sigmanssery/INAUSIS/DATA/RAWCHANNEL_2026-08-28.md

# 原始通道 + 單通道轉換(2026-08-28 夜)

## 為什麼

2026-08-28 語料庫顯示 C/D/F/G 在力道配平後分不開(見
`FINDINGS_2026-08-28_force-confound.md`)。封包只載三路 DoG 輸出,最快的
DoG_fast 到 150 Hz 已衰減 −32 dB,所以按壓之間若真有高頻差異,根本傳不出來。

## 兩個改動

**1. `dsp_chain.v`:dim 12 改載 CH0 原始值。**
只覆寫 `dog_flat`,旗標引擎仍由 feeder FSM 的 `lat_*` 餵,行為與 dead map 不變
(dim 12 仍報 dead=1 卻帶著活資料)。

**2. `ttcgs_board.v`:ADS 改成 `SINGLE_CH=1, SINGLE_IDX=0`。**

這一條才是關鍵。**改 dim 12 之後才發現原始值每 4~5 幀才變一次 —— 有效更新率
只有 159 Hz**,因為 ADS 仍在四通道輪詢,`CH0_ONLY` 只改了封包排程沒改轉換排程。
資訊 Nyquist 只有 79.5 Hz,跟 DoG_fast 的 70 Hz 截止幾乎一樣,**加原始通道等於白加**。

`SINGLE_CH=1` 只轉 AIN5(就是現用的 ch0),159 → 584 SPS,Nyquist 292 Hz。

    改前 dim12  run 4.34 幀  ->  159 Hz
    改後 dim12  run 1.09 幀  ->  631 Hz

> 2026-08-28 更正:本節下方曾記「市電佔靜止雜訊功率 61%」。那是拿一段手在附近的
> 錄音算的。手確實離開 30 cm 時只有 **3.5%**;手指輕放才是 85.8%。
> **市電是接觸傳導進來的**,見 `SLIDE_DETECT_2026-08-28.md`。

靜止雜訊頻譜實測(10~70 Hz 相對 100~300 Hz 的落差):

    159 SPS   −11.8 dB   (階梯保持造成的滾降)
    584 SPS   − 1.2 dB   (平坦到 345 Hz)
    d2 = G(s3) 參考:30 Hz 以上掉到止帶,平坦約 20 dB

**代價**:ch1~ch3 不再轉換,dims 3~11 凍結,dead map 由 `0x3F000` 變 `0x3FFF8`。
那三個通道沒接感測器。

## bitstream

    board_raw12.fs    只加 dim12,仍四通道輪詢(159 SPS)—— 無用,別拿來錄
    board_raw584.fs   dim12 + SINGLE_CH=1(584 SPS)—— 用這顆

資源 Logic 3820/8640、Fmax 37.763 MHz、Setup 違例 0。歸檔
`impl_archive/2026-08-28_board_raw12/`(前者)。

## 重要:不與 2026-08-28 語料庫相容

那 30 筆的有效取樣率是 159 SPS,這顆是 584 SPS。**DoG 的頻帶在兩者之下不同**
(舊資料的資訊上限 79.5 Hz),不可混在一起比。這顆錄的是獨立的高頻探測實驗。

還有:目前只燒在 SRAM,拔電就沒了。確定要用再 `-Flash`。

## 待答的問題

按壓類之間(C/D/F/G)在 79.5~292 Hz 有沒有可分的內容?
有 → 力道混淆有解;沒有 → 主張收窄成「滑動 vs 按壓」。

---

# 結果(8 筆,`2026-08-28_hf_mod*`,n=2/類)

## 高頻確實存在,而且以前完全看不到

接觸期間相對靜止的頻帶能量:

    類      0-20Hz   20-80Hz  80-150Hz  150-292Hz
    C/G/F   +52~58   +23~33   +17~20    +22~25
    E       +50~53   +22~27   +22~28    +26~32

80 Hz 以上有 +17~32 dB 的真實訊號。舊組態的資訊上限是 79.5 Hz,**這些內容從來
沒有離開過 FPGA**。

## 但高頻救不了 C vs G

    C1 vs G1   80-150Hz +0.7 dB   150-292Hz +0.1 dB
    C1 vs G2            +1.0                 +0.1
    C2 vs G1            +3.0                 +2.9
    C2 vs G2            +3.2                 +2.8

而 **C1 與 C2 之間就差 2.1~2.8 dB** —— 類內差異與類間差異同量級。
把頻寬拉大 4 倍之後,按壓類之間依然分不開,與白天力道配平的結論一致。

## 但滑動 vs 按壓拿到了力道穩健的特徵

**頻譜傾斜 = (150–292 Hz) − (0–20 Hz)**,這個量本身即對整體振幅正規化:

    按壓 (C/G/F)  -33.9 ~ -31.2 dB    |g3| 14300~18897
    滑動 (E)      -25.9 ~ -22.4 dB    |g3| 13514~17557
    間隙 5.4 dB

**兩者的 |g3| 範圍互相重疊**(E 落在按壓類之內),所以這是天然力道配平的比較。

    傾斜 vs 力道   r = -0.26
    fast/g3 vs 力道 r = -0.91   (白天那 30 筆)

力道依賴性從 r=−0.91 降到 −0.26。**這是目前唯一一個力道穩健、且需要原始通道
才算得出來的特徵。**

## 注意

n=2/類,r=−0.26 是 8 個點算的,不確定性大。這 8 筆與白天 30 筆取樣率不同,
不可合併。下一步應加錄重複數,並在**每一類之內刻意變化力道**,才能真正檢定
傾斜的力道穩健性 —— 白天的教訓就是類內力道太一致會製造假象。

---

# 刻意變力道的驗證(9 筆,`_f1/_f2/_f3`,合計 n=17)

每一類之內把力道拉開 1.9 倍(峰值目標 13000 / 22000 / 30000)。

    按壓 (C/G/F)  n=12   傾斜 -32.44 +- 1.05 dB   |g3| 11417~22028
    滑動 (E)      n= 5   傾斜 -24.80 +- 2.30 dB   |g3| 10797~20205

    均值差 7.65 dB   合併 sd 1.49   Cohen d = 5.15
    最小間隙 +3.3 dB(按壓最高 -30.7 對滑動最低 -27.4),不重疊

**力道依賴性消失:**

    傾斜 vs 力道   全體    r = -0.10 (n=17)
                   按壓類內 r = +0.04 (n=12)
                   滑動類內 r = +0.06 (n= 5)
    對照 fast/g3            r = -0.91 (n=30,白天)

兩類的 |g3| 範圍幾乎完全重疊,而傾斜在類內對力道毫無反應 —— 這不是碰巧配平,
是這個量本身就與力道無關。

**C vs G 依然重疊**(C −33.7~−30.7,G −33.9~−32.0),與力道配平、高頻探測
兩條證據一致:按壓類之間沒有可分的內容。

## 這批的效力邊界

* 單一受試者、單一場、單一感測器
* 滑動只有 n=5,且其 sd(2.30)大於最小間隙(3.3 dB)—— 多錄幾筆有機會吃掉間隙
* 力道範圍 1.9 倍,不是更大
* 兩個區塊(17:29~17:36 順序 C,G,F,E 與 17:47~17:54 順序 C,G,E)落點一致,
  但都在同一個 25 分鐘視窗內 —— **仍需斷電換序的第二場才算複現**,
  這正是白天那個教訓
