sigmanssery/INAUSIS/DATA/SOAK_2026-08-29_10h.md

# 10 小時靜置 soak(2026-08-29)

`2026-08-29_quiet_real10h.csv`,1.84 GB。組態:`board_final.fs`
(真實感測器、`SINGLE_CH=1`、`N_SQ=25`(5σ)、校正自癒、冷開機修正)。
感測器上方為 **MRE**(先前的 soak 用海綿,會乾掉;這次不會)。

## 主機端(`log_frames.py` 收工摘要)

    frames 24804408 in 36000.1s (689/s) | badCRC 0 | resync 0 | dropped 0 stale

## 檔案端(獨立重算,逐幀掃描)

    幀數        24,804,408      時長 10.00 小時      689.0 fps
    時戳跳號    0 次            遺失 0 幀 = 0.000000%
    dead map    0x3FFF8         24,804,408 幀全部相同
    status      1               全部相同
    mask 觸發   0 幀 = 0.000000%
    接觸旗標    0 幀            uncal 0 幀

兩邊獨立算出一致。**2480 萬幀零 CRC 錯誤、零丟幀、零狀態變化、零誤觸發。**

## 基線穩定度

    d2  逐小時均值 1781.19 -> 1780.62   = −0.57 counts / 10 小時
    d12 逐小時均值 1781.69 -> 1781.12   = −0.57 counts / 10 小時
    d2  的 sd 全程 2.15 ~ 2.20(十小時內幾乎不動)

## 第 8 小時的雜訊上升:是市電,不是感測器

    時   d0 sd    d12 sd
    0-7  7.40->7.64  31.7->36.4    緩慢爬升
    8    11.13       40.15         <- d0 跳 46%
    9    10.61       36.72

頻譜分解(60 秒窗):

    時段     寬頻(20-300Hz,扣掉市電線)   60Hz 線     120Hz 線
    第 2 h            63.4 dB              +14.5 dB    +30.1 dB
    第 8 h            63.7 dB              +24.6 dB    +34.3 dB
    第 9 h            63.3 dB              +29.1 dB    +31.4 dB

**寬頻底噪三段完全相同,漲的只有市電線(60 Hz +10~15 dB)。**
市電佔總功率:d12 由 37.1% 升到 53.6%,**d0 由 7.1% 升到 39.1%**。

d2 的 sd 不受影響,因為它濾到 1.8 Hz,60 Hz 進不去;d0 的通帶是 14~70 Hz,正中。
時間上對應早晨家電陸續開機。

## 最重要的結論

**即使 d0 的雜訊漲了 46%、市電佔到它功率的 39%,整整 2480 萬幀仍然零誤觸發。**

這比 2026-08-28 的「五次開機皆 0.00%」強:那是在安靜條件下量的,
這是在雜訊實際劣化的條件下撐住的。**3σ→5σ(`N_SQ` 9→25)的改動由此得到驗證** ——
3σ 時同一塊板的靜止誤觸發會在 0~16.94% 之間跳。

## 未解:市電是昨晚基準的十倍

    2026-08-28 夜、60 秒、手離開 30cm   d12 sd 25.94   市電佔 3.5%
    本次 soak 第 2 小時                 d12 sd 32.93   市電佔 37.1%

差十倍。**leading hypothesis 是 MRE**(順應層可能提供耦合路徑),
但**未經測試**,也可能只是時段/家電差異。

分辨方法:同一天、手完全離開、各錄 60 秒完整穩態,有 MRE / 無 MRE 各一次,
比 d12 sd 與市電佔比。若 MRE 是主因,那是**順應層的代價**,要寫進論文;
若不是,那是環境,不是設計屬性。

## 與先前鏈路數字的關係

2026-08-28 記的「186 萬幀、遺失 0.0106%」仍然成立,那批的遺失全部集中在單一檔案的
一次 0.29 秒中斷(`H_slide2`)。本次 10 小時連續錄製**零遺失**,樣本數大 13 倍。
兩者不衝突:前者含一次主機端中斷,後者沒有。
