sigmanssery/INAUSIS/DATA/DETECTION_SPEC_2026-08-28.md

# 偵測規格(2026-08-28 / 29)

真值來源分兩種:**合成刺激**(時序解析度,由建構決定)與
**真實接觸配上原始通道 dim12 當刺激真值**(偵測延遲)。兩者都不依賴操作者的一致性。

主張從「分辨手勢」收窄成「**告訴下游有沒有接觸、在哪一維**」之後量的規格。
這正是 TTCGS 本來的輸出:給下游 SoC 的注意力遮罩(`mask` / `mask_failsafe` /
`dead`),分類是後來才加上去、而且兩次複現都失敗的東西。

真值由 `synth_press` 建構決定,**不依賴任何人的手**。

## 靜止誤判率

**只用確定沒接觸的錄音**(手離開 30 cm / 懸空 2 cm / 手指靜放不施力 /
冷開機檢查),合計 **80,424 幀 = 116.7 秒**:

    接觸旗標 (status bit2)   0 幀
    mask dim0 (DoG_fast)     0 幀
    mask dim1 (DoG_slow)     0 幀
    mask dim2 (G_s3)         0 幀

**三個活維度全部零誤觸發**,包括手指靜放在感測器上的 30 秒。

> **更正**:本節原記 dim0 誤觸發 0.606%。那個數字是拿語料庫檔案的「前 3 秒」
> 當靜止算的,而那些窗並非靜止(`H3_slide2` 一開始就在滑,d0 變異 423,240)。
> **同一個錯誤犯了兩次**(另一次是挑 `VAR_CEIL` 的基準值)——
> **靜止基準只能用確定沒碰過的錄音。**

對照:真實按壓時 dim0 的觸發持續中位 28 幀 = 40 ms(n=26,全距 1~59)。

## 偵測延遲:用真實接觸重測(2026-08-29)

合成刺激那條路被白雜訊擋住(見下),但**原始通道 dim12 本身就是精確的刺激真值** ——
它是未濾波的轉換器輸出。以「raw 跨過自身峰值 10%」為起點、
「mask 任一活維度拉起」為終點,量既有的真實按壓/滑動錄音:

    115 個事件(`2026-08-28_H2_*` 與 `H3_*`)
    延遲中位 **2 個樣本 = 2.90 ms**,全距 0~6 樣本
    與事件峰值無關(22000~30000 與 30000+ 兩箱皆為 2 樣本)

### 5σ 重測:延遲不變(2026-08-29 定案)

以現行 5σ 組態重錄:

    firm 按壓 8 次   延遲 **全部 2 樣本**,零離散
    分級按壓 16 次   中位 2 樣本,16 個裡 14 個落在 2~3 樣本
    合計 24 個事件於 5σ;對照 3σ 的 115 個事件,中位同為 2 樣本 = 2.90 ms

**門檻提高 2.78 倍完全沒有增加延遲。** 按壓的上升緣夠陡,DoG_fast 在同一個
樣本內衝過兩個門檻,所以延遲由**核的前載形狀**決定而非由門檻決定。

### 為什麼偵測下限用手指探不到

要求操作者做「由弱到強」的階梯後發現:

    raw(未濾波瞬時值) 峰值 24857 ~ 30986   <- 幾乎不隨力道變化
    d2(低通後持續載荷)峰值  4828 ~ 19929   <- 六倍跨度

**手指再輕,接觸的上升緣仍然很陡**,raw 照樣接近滿刻度;變輕的是持續載荷。
而偵測由快頻帶觸發,所以每一次都輕鬆越過門檻 —— 16 次全部偵測到,零漏。

**要接近偵測下限,需要「振幅小 *且* 上升緩慢」的刺激,那是手做不出來的。**
這正是合成產生器的用途,而那條路目前卡在白雜訊(見下)。
**下限因此仍然未知,原因是刺激源而不是設備。**

### 為什麼 2.90 ms 在機制上說得通

濾波器核是**因果且前載**的,不是置中的對稱高斯:

    G_s1      能量重心 tap  5.3 =  7.7 ms   峰值在 tap 5
    G_s2      能量重心 tap  9.1 = 13.1 ms
    DoG_fast  能量重心 tap  9.2 = 13.4 ms   50% 能量在 tap 7 = 10.2 ms
    G_s3      能量重心 tap 67.0 = 97.2 ms   <- 只有它是長的

tap 0 就有權重,所以陡峭上升緣一進來輸出立刻開始動。
若核是置中對稱的,群延遲會是 128 樣本 = 186 ms,那與觀測不符。

## 偵測下限:沒有硬下限,是一條延遲—振幅曲線(2026-08-29 定案)

合成產生器的白雜訊問題**已修**(見文末的 LFSR 根因),校正因此得到合理的門檻,
`dim2` 不再 free-run。以精確真值(產生器的週期起點)為基準重測:

| 設定峰值 | 延遲(樣本) | 延遲(ms) | n | 偵測率 | 逐次 |
|---|---|---|---|---|---|
| 14025 | 6 | 9.4 | 2 | 100% | 7 6 |
| 6985 | 8 | 11.6 | 2 | 100% | 8 8 |
| 3520 | 10 | 13.8 | 2 | 100% | 10 9 |
| 1760 | 10 | 15.2 | 2 | 100% | 10 11 |
| 880 | 14 | 21.0 | 2 | 100% | 14 15 |
| 440 | 19 | 27.6 | 2 | 100% | 20 18 |
| 385 | 21 | 29.8 | 4 | 100% | 18 22 19 22 |
| 330 | 21 | 30.5 | 4 | 100% | 21 21 16 21 |
| 275 | 24 | 34.1 | 4 | 100% | 26 26 21 20 |
| 220 | 29 | 41.4 | 4 | 100% | 31 26 23 37 |
| 165 | 28 | 39.9 | 4 | 100% | 40 26 29 24 |
| 110 | 44 | 63.9 | 4 | 100% | 48 44 39 44 |
| **55** | **70** | **100.9** | 4 | **100%** | 69 70 68 70 |

**兩段掃描(28000~219 粗掃、440~55 細掃)都是 100% 偵測,探不到底。**
55 counts 對靜止 raw 的 sd 37 只有 **1.5σ**,仍然偵測得到 ——
DoG 在通帶內平均了約十個樣本,濾波後的信噪比遠優於逐樣本。

**這不是誤觸發**:55 counts 那四次的延遲是 69/70/68/70,緊到不可能是雜訊;
且同組態靜止十小時、2480 萬幀零誤觸發(`SOAK_2026-08-29_10h`)。

**因此正確的規格陳述是「延遲隨振幅上升」,不是「下限是某個值」。**
上升時間固定 55 樣本(80 ms),所以 55 樣本以下的延遲代表在爬升途中就報了;
55 counts 那一列的 70 樣本已進入持平段。

> 量到的峰值一律比設定高約 99 counts,那是用 `max()` 取峰值被雜訊尖峰墊高的
> (sd 37 之下,約 1000 個樣本的最大值約在 +3σ),不是刺激本身。

## ⚠ 舊的合成刺激版(白雜訊污染,不可用)

**這一節的數字被合成刺激的一個限制污染,尚未重測。**

`synth_press` 的雜訊是 LFSR 產生的**白**雜訊。G_s3 只通 0.2~1.8 Hz,白雜訊幾乎被
濾光,所以校正窗量到的 G_s3 變異只有 **0.1**(真實感測器是 4.16,因為真雜訊含
1/f、市電與熱漂移)。門檻因此被設得極低,**dim2 在整段掃描中有 31% 的幀在誤觸發**。

而延遲與下限是用「dims 0/1/2 任一拉起」量的,其中一維在亂跳,結果不可信。

要重測需要二選一:
* 讓 `synth_press` 的雜訊帶低頻成分(對 LFSR 做整形),使 G_s3 被真實地驅動
* 或改用真實接觸量偵測(按壓的偵測不像滑動那樣依賴執行質地,可行)

**不受影響的是靜止誤判率** —— 那是用 `SYNTH=0`、真實感測器量的,見上一節。

## (原始記錄,待重測)

`2026-08-28_detect_sweep2.csv`,160 秒、峰值對數掃描,每級 3 次。
延遲從「刺激跨過自身峰值 10%」起算到 mask 任一活維度拉起。

| 設定峰值 | 量到峰值 | 偵測率 | 延遲(樣本) | 延遲(ms) |
|---|---|---|---|---|
| 28000 | 28042 | 100% | 5 | 7.3 |
| 14025 | 14067 | 100% | 5 | 7.3 |
| 6985 | 7028 | 100% | 8 | 11.6 |
| 3520 | 3562 | 100% | 57 | 82.7 |
| 1760 | 1799 | 100% | 98 | 142.2 |
| 880 | 921 | 100% | 186 | 270.0 |
| 440 | 480 | **0%** | — | — |
| 219 | 257 | **0%** | — | — |

**偵測下限在 440 ~ 880 counts 之間**(靜止 d2 的 sd 為 2.4 counts)。
參考按壓的延遲是 **4 個樣本 = 5.81 ms**,三次重複完全相同。

延遲隨振幅單調上升,是門檻偵測器在斜坡刺激上的必然行為:訊號越小,
越晚跨過門檻。門檻可經現有反向通道(`lut_parser`)重調,
所以這條曲線是**可移動的設計取捨**,不是固定限制。

## 原始通道在正常按壓時削頂(2026-08-29)

    接觸期間 33,409 幀中有 9,370 幀 raw >= 32700 = **28.05%**
    每事件被削的樣本中位 34~89(約 49~129 ms),事件長約 250~350 樣本
    d2(濾波後)幾乎不削 —— 只有 0.79%,且僅見於一筆

**已驗證這不影響 H 的結論**:把削頂樣本整個排除後重算,
兩類中位由 3.08 / 3.84 升到 3.40 / 4.02,但 **Cohen d 1.16 → 1.13、
門檻 3.30 的正確率 64.6% → 63.9%** —— 分離度不變。
(此處 d 較低是因為併了兩場,而第二場的滑動側已知塌掉。)

但它仍是一個真實的動態範圍限制:**分壓比/PGA 增益使得偏重的按壓會撞上 ADC 滿刻度**,
峰值附近的高頻內容因此被削掉。若要保留那段內容,需改 `R_div` 或 PGA ——
但那會改變所有既有的校正與基線,是獨立的決定。

## 一個必須記下的失效模式:校正窗被污染

第一次掃描 **mask 在全部 110,355 幀都是 0**,從未觸發。

原因:`zscore_flag_multi` 只在開機後前 `CAL_N = 512` 個樣本校正一次,而合成刺激
一啟動就按壓,一次按壓 234 個樣本**整個落在校正窗內**。引擎量到滿刻度的變異、
把門檻設到無法到達,之後永久失效。

加上 1400 樣本(約 2 秒)的靜默前導後,mask 觸發 35,515 / 110,354 幀。

**這會發生在真實硬體上:開機後 0.74 秒內若有任何東西碰到感測器,
注意力輸出就永久失效,而且不會自我恢復。**

這是今天第二次遇到「校正一次、且校在髒資料上」——
第一次是冷開機時 ADS 輸出全零,導致 dead map 全死(見 `COLDSTART_2026-08-28.md`)。
**同一個結構性弱點:一次性校正沒有有效性檢查。**
建議(未實作):校正後檢查變異是否落在合理範圍,超出則重做。

---

# 合成雜訊的根因與修法(2026-08-29,已解)

## 症狀

合成刺激下 `G_s3` 的靜止變異只有 **0.1**,真實感測器是 **4.65**。門檻因此低到
`dim2` 幾乎持續觸發,第一次偵測下限掃描整個作廢。

## 走錯的路(丟掉一整晚)

假設真實雜訊是 1/f,想用漏積分器「補低頻」。**假設本身是錯的。**

拿 10 小時 soak 的第 2 小時、5 分鐘窗量真實靜止頻譜:

    0.1~1 Hz  1~5 Hz  5~20 Hz  20~60 Hz   相對 1~5 Hz
     -0.0 dB  +0.0 dB  +0.2 dB   +1.2 dB
    細看 G_s3 通帶內:0.1~0.3 / 0.3~0.6 / 0.6~1.0 / 1.0~1.8 Hz
                      +0.4    +0.1     -0.4     +0.0 dB

**真實雜訊在 0.1~30 Hz 平坦到 ±0.4 dB —— 是白的,沒有 1/f。**
抬高的只有 60~200 Hz 的市電諧波。異常的是合成端,不是真實端。

## 真正的根因:LFSR 每個樣本只移一位

`lfsr[6:0]` 取 7 個位元,而每個樣本只右移一位 ——
**相鄰兩個樣本共用其中 6 個位元**,序列因此強相關,不是白雜訊。

Python 用真實量化係數驗證(每個樣本推進的步數):

    步數/樣本   raw 變異   d2 變異   d2/raw     相鄰自相關
        1        1365.2     0.151   0.00011      -0.247
        2        1370.5     5.960   0.00435      -0.130
        8        1366.1     9.092   0.00666      -0.002
    真實感測器    1085.0     4.650   0.00429

**每樣本推進 8 步**(8 個位元不重疊)就恢復成白雜訊。
八步線性遞迴仍是線性的,所以合成成一個固定 XOR 網路,不佔時脈。

與真實值 0.00429 的殘差**不是缺陷**:真實訊號有 30~40% 的功率在 60 Hz 以上的
市電諧波,那些被 `G_s3` 擋掉,所以真實比值低於純白雜訊。合成端不該複製市電,
**0.0066 就是正確的目標**。

## 硬體驗證

修法後同一顆合成 bitstream:`dim2` 在 12 個零載荷週期**全部 0% 觸發**,
只在產生器刻意施加載荷的 4 個週期觸發 100%,而量到的抬升
(+48 / +90 / +170 / +327)精確追蹤設定值(40 / 80 / 160 / 320)。

> 先前記的「dim2 free-run 31~57%」歸因有誤 ——
> 那批數字混了校正窗污染與這個**合法**的載荷觸發。

## 方法論

昨晚在 RTL 上連續猜錯四次;今天先在 Python 用真實係數把假設驗完才動 RTL,
一次就對。**先量目標(10 小時 soak 給了真實頻譜),再設計。**
