sigmanssery/INAUSIS/DATA/FINDINGS_2026-08-28_force-confound.md

# DoG 頻帶比主要在量力道,不是手勢(2026-08-28)

## 結論

**`fast/g3` 與 `slow/g3` 有 83% 的變異由接觸力道 |g3| 解釋**(30 筆,
r = −0.912,log-log 回歸斜率 −1.63:力道加倍,fast/g3 掉到 0.32 倍)。
類內相關 C −0.90、D −0.89、E −0.98、F −1.00、G −0.98。

力道配平(|g3| 相差 <5%)後兩兩比對:

| 比較 | n | fast/g3 差異中位 | 全距 |
|---|---|---|---|
| 同一類,力道差 >15% | 27 | **39%** | 最大 83% |
| C/D/F/G 彼此,力道配平 | 25 | **8%** | 0~27% |
| E vs 其他,力道配平 | 18 | **38%** | 25~57% |

**改變力道的影響是改變類別的五倍。** 具體的配平對照:

    C5 vs G3   |g3| 15150/15626   fast/g3 0.125 / 0.125   差 0%
    C4 vs D5   |g3| 18321/18118   fast/g3 0.095 / 0.096   差 0%
    F6 vs G1   |g3| 14544/14053   fast/g3 0.151 / 0.151   差 0%
    C6 vs G6   |g3| 18792/18807   fast/g3 0.090 / 0.088   差 3%

**C、D、F、G 在力道配平後分不開。E 分得開。**

## 這是怎麼被發現的

第一場(2026-08-28 12:31~16:28)五類各連續錄一批,十對可分性全部通過,
最弱 3%。**那是假象**:每類各自的力道剛好穩定,而五類本來就落在不同力道水準
(D 最重 17520~21309,F 最輕 8930~14544)。類別與錄製時段完全混淆。

第二場依協定斷電重開、**類別順序倒過來**(G→E→C→F→D)各錄 2 筆之後,
**十對裡有五對變成兩軸都重疊**。第二場執行本身沒問題 —— 事件數、提示標記、
幀率、零貼頂、零時戳跳號全部與第一場吻合,變的只有力道。

協定「分兩場、中間斷電、換順序」這條規則就是為了抓這個,而它抓到了。

## 還剩下什麼

**E(單向拉撫)vs 按壓類**,力道配平後仍差 38%,是乾淨的。與波形圖一致:
E 的 d0 在整個接觸期間是持續振盪,C/D/F/G 都是單一暫態尖峰 —— 滑動與按壓
是兩種物理過程,而「節奏不同的按壓」不是。

C/D/F/G 之間唯一 10/10 可分的特徵是**事件率**(最弱間隙 13%),但事件率是
節拍器規定的,不是量出來的,拿來當分類結果是循環論證。

試過但無效的力道無關特徵(皆 n=6/類,注意多重比較):
力道迴歸殘差 4/10、|d0| 佔空比 3/10、峰值位置佔比 3/10、d0 對 d2 峰值延遲 4/10。

## 與 chirp 結果的關係(不衝突)

先前的 chirp 特性描述(Spearman 1.0000、16 倍振幅範圍內不變 0.2~8.7%)仍然成立,
但那是**固定波形、只縮放振幅**。人手加大力道不是把波形放大 —— 上升較慢、接觸較久,
**形狀就變了**,比值對此並不免疫。

正確的說法是「**對振幅不變**」,不能寫成「對力道不變」。

## 建議

不要再為 C/D/F/G 補資料 —— 力道配平的配對已經在手上,答案是 0~8%,
再錄不會改變。要嘛把主張收窄到「滑動 vs 按壓」,要嘛換一條特徵路線。
