sigmanssery/INAUSIS/DATA/FRONTEND_RESOLUTION_2026-08-28.md

# 前端解析度(合成刺激,真實 RTL)

## 為什麼要做

2026-08-28 的手勢語料庫量到的是**手**,不是前端:同一操作者的上升時間 sd 是
43 ms,而前端的解析度是 1.45 ms —— **差 30 倍**。用手做的手勢無法支撐任何關於
前端解析度的主張,因為執行變異把儀器解析度整個淹掉。

## 做法

`synth_press.v` 在 FPGA 內產生梯形按壓串,經 `SYNTH=1` 取代 ch0 的轉換器樣本。
**下游全部是出貨邏輯** —— 真實的整數 MAC、`>>FRAC`、飽和、旗標引擎、封包器、
鏈路。手和感測器都被移除,剩下的只有前端本身。

32 步程式,四個 8 步階段各掃一個參數,每階段從同一個基準按壓出發,
步進 0/1/2/3/5/9/17/33 單位。step 索引輸出到 dim 13(`AUX_DIM`),
主機直接讀,不必推論順序。噪聲由 LFSR 產生(均勻,sd≈37)。

> **更正(2026-08-29)**:此處原寫「對照實測 raw 的 44.2」。那個 44.2 是傍晚錄的,
> 當時手在附近,市電經接觸傳導把雜訊抬高了近一倍。**手確實離開 30 cm 時是 25.94**
> (60 秒、41,454 幀、整段計算)。所以 LFSR 的 sd≈37 其實比真實感測器**高** 1.4 倍,
> 不是原本以為的略低。這使本文的解析度數字偏保守,結論方向不變。

`2026-08-28_sweep32_long.csv`,160 秒 = 3~4 輪。

## 結果

| 參數 | 設定步進 | 量測步進 | 重複 sd | 解析度 |
|---|---|---|---|---|
| 上升時間 | +1 樣本 | +1.0 樣本 | **0.00** | **1 樣本 = 1.45 ms** |
| 持續時間 | +1 樣本 | +1.0 樣本 | **0.00** | **1 樣本 = 1.45 ms** |
| 按壓間載荷 | +5 counts | +5.5 counts | 1.2~4.6 | **約 5 counts** |
| 峰值 | −140 counts | −148.7 counts | 0.4~7.1 | **約 15 counts = 0.05%** |

上升時間用 10–90% 判準,所以量測斜率是設定的 0.8 倍(0.8×55=44、0.8×88=70.4),
逐步的 +1 對 +1 是在該斜率下的完全追蹤。持續時間是 1:1(+16 設定 → +16 量測)。

## 對照:同一操作者的執行變異

(語料庫 C 類 6 筆、48 次真實按壓)

    上升時間  中位 177 ms   sd 43.4 ms   = 30 樣本    -> 前端好 30 倍
    接觸時長  中位 360 ms   sd 47.7 ms   = 33 樣本    -> 前端好 33 倍
    峰值      中位 26839    sd 3103 counts = 11.9%    -> 前端好 200 倍

## C 與 G 為什麼分不開,精確答案

兩者的定義差異是「按壓之間手指在不在表面上」。操作者實際做出的按壓間載荷是
**0~3 counts**(見 `FINDINGS_2026-08-28_force-confound.md`),而前端要 **5 counts**
才分得出來。**那個差異落在解析度以下** —— 不是特徵不好、不是頻寬不夠,
是該手勢定義所產生的物理量太小。

FSR 轉導的是力。手指放著但不施力,訊號上不存在。

## 效力邊界

* 噪聲是均勻 LFSR 的**白**頻譜,不是實測頻譜。**這對本文的時序解析度無影響**
  (上升/持續/載荷只看波形),但**使同一支產生器無法用來量偵測門檻** ——
  G_s3 只通 0.2~1.8 Hz,白雜訊幾乎被濾光,詳見 `DETECTION_SPEC_2026-08-28.md`
* > **更正**:此處原寫「實測有 61% 功率在市電線上」。那是手在附近時算的;
  > **手確實離開時市電只佔 3.5%**,見 `SLIDE_DETECT_2026-08-28.md` 的市電對照
* 單一組態、單一板子
* 這是**解析度**(能分辨多小的差異),不是**準確度**(絕對值對不對)
* 建置 Logic 4465/8640,只用於特性描述,不是量產組態
