sigmanssery/INAUSIS/DATA/PROTOCOL_MODALITY.md

# 接觸方式協定 (2026-08-27 定案:五類,直接接觸)

> ## ⛔ 這套五類語料庫已不能用於分類主張(2026-08-28 起)
>
> 依此協定錄的 30 筆語料庫**量到的是操作者的手,不是前端**:
> 同一操作者的上升時間 sd 是 **43 ms**,而前端的解析度是 **1.45 ms** —— 差 30 倍。
>
> * **C 對 G 分不開**:兩者的定義差異(按壓之間手指在不在表面)只產生
>   **0~3 counts**,而前端要 **5 counts** 才分得出來 —— 落在解析度以下。
>   FSR 轉導的是力;手指放著不施力,訊號上不存在。
> * 本文下方所有「頻帶比 C 0.24 vs G 0.37」「逐筆完全不重疊」的數字
>   **已被力道混淆推翻**(`fast/g3` 有 83% 變異來自力道,r=−0.912)。
> * 第一場「十對全部分開」是**類別與錄製時段完全混淆**的假象;
>   斷電換序的第二場有五對變成兩軸都重疊。
>
> **協定本身(手勢定義、提示音、峰值目標)仍然有效**,可用於記錄真實接觸;
> 不可用於支撐手勢分類的能力主張。
> 詳見 `FINDINGS_2026-08-28_force-confound.md` 與 `SESSION_2026-08-28_LEDGER.md`。

檔名:`YYYY-MM-DD_FSR402_mod<字母><重複編號>_raw.csv`

## 五類 x 7 次 = 35 筆

| 代號 | 手勢 | 30 秒內目標 | 單次時長 | 峰值 counts |
|---|---|---|---|---|
| **C** | 規律按壓,力道有變化 | 約 8 次 | **0.15~0.6 s** | 27000~30000 |
| **D** | 單次施力—放鬆(彼此分開) | 約 7 次 | 各自分離 | 27000~30000 |
| **E** | **單向拉撫**(只拉不推) | 持續 | — | \|g3\| 15000 上下 |
| **F** | 指甲敲擊 | 約 45 下 | 短促 | 不設目標 |
| **G** | 快速規律按壓,**全程不放開** | 約 20 次 | ~0.35 s | 27000~30000 |

**字母跳過 A 和 B,不重新編號** —— 舊批次的同名檔是別的手勢。

## 用提示音錄製(2026-08-28 起)

`log_frames.py` 內建節拍器,**提示時刻會寫進 CSV 的 `cue` 欄**(3=預備低音 400 Hz,
1=按下音 1000 Hz,2=放開音 500 Hz,0=無)。分析時因此有指示時刻的基準真值,不必再從訊號反推事件。
排程用絕對時間,實測 48 拍累積誤差 7.1 ms。

第一聲是**預備低音**(`--cue-leadin`,預設 1 聲),之後才是按下音;08-28 的 C1~C4 有
三筆漏掉第一拍,加這聲就是為此。預備音之前留一段乾淨靜止窗供 sd 基準用。

標記寫進 CSV 的時刻誤差 **+3~12 ms**(讀取塊 512 B)。曾用 4096 B,誤差是 +70~100 ms
—— 標記只能掛在「主迴圈處理到那一列」時,塊越大偏得越多。**不要調回 4096。**
逐列的絕對時間請用硬體時戳 `ts`(每幀 +1),`t_s` 是主機端寫入時刻。

**每一類的提示音都不一樣,不能沿用上一類的。** 2026-08-28 第一批就是整批套用 C 的
`3.5/0.4`,結果 D、E、F 三類全部作廢重錄。指令照抄下面五行,只改檔名:

    # C  規律按壓、力道有變化   8 拍
    python log_frames.py --port COM7 --secs 35 --cue-period 3.5 --cue-hold 0.4 --out ..._modC1_raw.csv

    # D  單次施力—放鬆、彼此分開   7 拍。放開音響了要真的鬆到基線,
    #    否則相鄰兩次會黏成一個事件(D1 曾整場只剩 1 個 7.3 秒的事件)
    python log_frames.py --port COM7 --secs 35 --cue-period 4.0 --cue-hold 0.5 --out ..._modD1_raw.csv

    # E  單向拉撫   全程不下提示。只拉不推,回程手指抬離再放回,不要順勢帶過去
    python log_frames.py --port COM7 --secs 35 --out ..._modE1_raw.csv

    # F  指甲敲擊   45 拍。節奏快,預備音給 4 聲當數拍
    python log_frames.py --port COM7 --secs 35 --cue-period 0.625 --cue-leadin 4 --out ..._modF1_raw.csv

    # G  快速規律按壓、全程不放開   20 拍。沒有放開音,手不離開感測器
    python log_frames.py --port COM7 --secs 35 --cue-period 1.5 --out ..._modG1_raw.csv

錄的時候盯著畫面上的 `d2`,那就是壓力。C/D/G 目標 28000 上下,**不要超過 31000**
—— 32767 是滿刻度,壓到頂峰會被削平,振幅資訊就沒了。

## E 從「推拉撫摸」改成「單向拉撫」(2026-08-28)

原本的 E 是推拉來回撫,**推和拉是兩種物理過程混在一起**,每筆的混合比例又不同,
結果 fast/g3 的類內全距 0.282~0.588,而且**和 F 在兩個軸上都重疊**。

改成只拉不推之後:

    fast/g3 類內全距   混合 0.306  ->  單向 0.011   (差 28 倍)
    對 F 的間隙        兩軸都重疊  ->  31%

**推 vs 拉的振動假設沒有得到支持**,但這個實驗本身測不到:DoG_fast 的 -3dB 通帶
是 14.2~70.0 Hz(峰值 33.2 Hz),而封包裡只有三個 DoG 輸出、沒有原始通道。推的黏滑
振動典型在 50~300 Hz,**在 FPGA 裡就被濾掉了,傳不到主機**。要驗證得先讓封包載一路
原始值(dim 12~17 是死的,ch4/ch5 沒接感測器,可以挪一個)。這是另一條路,不在
語料庫路徑上。推的 3 筆(`modEpush1~3`)與混合的 4 筆(`modEmixed1~4`)都保留。

**單向拉撫的接觸振幅 |g3| 是 15354~15917,落在 C(11455~18321)之內、和 G
(12824~15626)重疊。** 這點很重要:原本的輕撫是全場最輕的一類(5757~10248),
「分得開」隨時可以被說成只是在分按壓力道;現在振幅受控,分得開就是動態分得開。

## F 從「刮」改成「敲」(2026-08-28)

**MRE 表面摩擦力太低,指甲刮不出刮的觸感,只會滑。** 這是表面物理的限制,不是執行
問題 —— 跟當初刪 A、B 的理由同一類,但更硬。

改用**指甲敲擊**:不需要摩擦力,而且是真正的快速暫態,才撐得起 DoG_fast 那一支。

實際錄到的「滑動」本來也考慮過保留(fast/g3 = 0.270 [0.196~0.314],剛好落在
C 0.115 和 E 0.536 之間),但**它和 E 分開靠的不是快頻帶能量**:絕對值 |fast| 是
E 2794~3254 對 F 2337~2986,完全重疊,分數會分開純粹因為分母 g3 差很多
(E 4053~7605 對 F 9048~11895)。也就是說那兩類是被**接觸力道**分開的,不是被
指甲 vs 指腹分開的 —— 輕撫按重一點就會滑進去。拿這個當時序/多尺度的證據會被打。

**敲擊 vs G 必須先驗證再定案。** 當初刪 A(快速輕敲)的理由是「跟 G 的頻帶比
分不開,0.38 vs 0.37」,但那是舊的離線頻帶比配舊資料。改用 fast/g3 有原理上的
理由相信分得開:**G 全程不放開所以 g3 一直墊高,敲擊每次都回到基線**,分母行為
根本不同。先錄 4 筆算 fast/g3,分得開才換掉 F。

## 刪掉的兩類與理由

**B 緩慢按壓**:六次重複的單次時長 0.06/0.04/0.07/0.11/1.12/2.11 s,類內差 50 倍;
事件數與接觸比例和 C、D 完全重疊。指示過於主觀,無法一致執行。

**A 快速輕敲**:可重現(四筆都剛好 40 次、3.7~4.0 Hz),**但與 G 的 DoG 頻帶比
分不開(0.38 vs 0.37)**。兩者執行上確有差異(A 低於基線的時間 72~81%,G 只有
60~64%,且 G 的最低值從未跌破基線),但那個差異不足以移動頻帶比。另外 A 在每次
敲擊的上升緣前會出現負讀值(−854 ~ −3093),與打滿無關,疑似轉換器低延遲濾波器
在陡峭階躍上的振鈴,尚未查證。

保留 G 而非 A,因為論文的關鍵比較是 C vs G。

## C 與 G(論文關鍵)

    振幅   C 28076  vs  G 28588   相差 1.8%
    頻帶比 C 0.24    vs  G 0.37    差 1.57 倍
    逐筆   C 0.24/0.24/0.25/0.23   G 0.36/0.39/0.36/0.42   完全不重疊

兩類峰值要盡量相同,差別只在節奏與是否放開。

## 硬體配置

    R_div = 板上 0201 100k ∥ 91k 通孔 = 47.6 kohm
    靜止基線 ~1780,sd 24.9 (2026-08-27 實測,目前最佳)
    E 的訊噪比約 10.7 sigma

**感測面本身是 MRE**,那是設計的一部分,不是後加的。以下規則是針對
**在 MRE 之上再加**的順應層 —— 焊接海綿試過,兩種狀態都不行:

* 濕的會導電,隔著 FSR 的 Mylar 絕緣層**電容耦合注入市電**(絕緣完好,水沒碰到
  電極,是整片濕海綿在當天線)。實測多出 58 counts,其中 48.5 在 55~70 Hz。
  乾燥到失去導電性時會**階梯式**消失(soak 第 6.9 小時)
* 乾的沒有彈性回復,指痕五分鐘不退,每按一次基線永久偏移

若日後要做額外順應層的實驗,材料需**有彈性回復、不導電、不吸水**(矽膠片、EVA 泡棉),
且應為獨立實驗,不混入主語料庫。

> 2026-08-28 更正:本節原本寫成「不要放任何順應層」,被誤讀成連 MRE 都不該在。
> MRE 是感測面,語料庫全部在 MRE 上錄製。

## FFC 尾巴必須用膠帶固定

側向接觸(E、F)會拉扯 FSR 的 FFC 排線造成內部接觸瞬斷:

    壞掉時: 相鄰樣本差中位 270 counts, 29% 的相鄰對差 > 500
            讀值跌到 2.27 Mohm,而未受力只有 0.83 Mohm
    固定後: 相鄰樣本差中位 24, 差 > 500 佔 0.000%

Kapton 或紙膠帶平貼桌面,離作用區幾公分,**不要跨過作用區**。

## 開頭的陳舊資料(2026-08-28 修正)

板子持續在送,主機沒讀時資料堆在驅動與 FTDI FIFO 裡。舊版 `log_frames.py` 一開檔
就把那些倒進來,**每個檔的前約 150 列是上一次錄音的殘留**,接縫處時戳跳幾百到
八千幀。E2 那 150 列的 d2 是 21738 —— 上一筆的按壓。

`ser.reset_input_buffer()` 擋不住(在途的 USB 傳輸清不掉,實測仍漏 74 列)。
現行版本改成**解析時判定**:前一秒的幀先留在記憶體,找出最後一個時戳不連續處,
把之前的全丟掉,收工時印 `dropped N stale`。

2026-08-28 那 20 筆語料庫**不需重錄** —— 丟掉前綴重算,十對可分性只動了
33%→32%、15%→16%,基線用中位數吃不動 0.6% 的汙染。

## 錄製條件

- 每筆 **30 秒**
- **開始錄之前手就要完全離開**,不是下指令之後才收手(收手動作實測 sd 580)
- 前 3~5 秒完全不動
- 每次重複刻意變化位置、力道、節奏
- **分兩場,中間拔 USB 斷電,而且第二場要換類別順序**

  這條**不是為了上電校正** —— 已在 RTL 查證:`zscore_flag_multi` 的校正只餵旗標與
  遮罩,`dog_store` 拿的是 `lat_fast/lat_slow/lat_g3`,**d0/d1/d2 是純 FIR 輸出,
  與校正無關**,斷電重來不會改變它們。

  這條是為了拆掉**「類別 = 錄製時段」的混淆**。若一整類連續錄完再換下一類,整個下午
  的任何漂移(溫度、手指濕度、感測器潛變、MRE 回彈)都會偽裝成類別差異。
  2026-08-28 那批就是這樣錄的,五類各自是一個連續時段。

  部分反證:該批的 C1 與 D2 是 3 小時後補錄的,兩筆都落回自己類別內;
  靜止基線 4 小時只漂 7 counts(1787→1780,r=-0.506)。但 n=2 太少,
  **仍需第二場斷電、換順序的對照**,尤其 C vs D 和 C vs G 只有 3% 間隙。
- 盯著 `peak`,**不要超過 30000**

## bitstream

`dual_rec689b.fs` —— mode-1 SPI、比例式 AVDD 參考、連續轉換、CH0_ONLY、690 rows/s
