sigmanssery/INAUSIS/DATA/RESOURCES_2026-08-28.md

# 資源與時序(2026-08-28 / 29)

> ## ⚠ 論文引用 **v6**,在本文最後的「量產組態 v6」一節
>
>     Logic 4374/8640 (51%)   Register 2386   BSRAM 5   DSP 5/10 (50%)
>     Fmax 37.301 MHz   Setup/Hold 違例 0   37.051 mW
>     封存 impl_archive/2026-08-29_board_production_v6_dspcut/(src/ 12 個 as-built 檔)
>
> v6 對 v5 的唯一差別是把 `N_SQ * cal_var16` 這個**常數**乘法強度削減成移位加法。
> **行為位元相同**(300,012 個值含邊界全域驗證,零不符),所以 v5 上量到的
> 十小時 soak、5σ 靜止零誤觸發、偵測延遲全部沿用有效。
> **但板上燒的仍是 v5 的位元流** —— 要完全乾淨得燒 v6 再跑一次靜止確認。
>
> **`DSP 7.5` 那個數字已作廢,不要再引用。**
>
> 本文開頭這一節記的是 **v1**(Logic 3711):**沒有**原始通道、**沒有**板上判別器、
> **沒有**冷開機修正、**沒有**校正自癒。它不是出貨設計,保留只為追溯鏡射代價。
> 中段另有 v2 / v3 兩份作廢表,同樣僅供追溯。
>
> 版本演進:v1 → v2(加 raw + 判別器,**作廢:早於冷開機修正**)
> → v3(加冷開機修正,**作廢:早於校正自癒**)
> → v4(加校正自癒,**作廢:早於 5σ 門檻**)
> → v5(加 5σ,**作廢:DSP 數字被 v6 取代,行為仍等價**)→ **v6(現行)**
>
> **同一個錯誤犯了三次:改完 RTL 沒有重跑資源建置。**

## v1:只有前向資料路徑(僅供追溯鏡射代價)

原記「論文引用量產組態(`localparam MIRROR = 1'b0`)」。
bring-up 用的 UART 鏡射不屬於部署設計,已排除,其代價另列於下以供對照。

兩次跑次同一份原始碼、同一天、同一個 `board_pnr.tcl`(GW1NR-LV9QN88PC6/I5,
`board.sdc` 約束 clk27 = 27 MHz),各自 `run all` 後立刻歸檔:

    impl_archive/2026-08-28_board_production_MIRROR0/   <- 論文引用這個
    impl_archive/2026-08-28_board_recording_MIRROR1/    <- 只用來算鏡射代價

兩份都含 `ttcgs_board.v.asbuilt`,可核對編出來的到底是哪個組態。

### v1 資源表

| 項目 | 用量 | 佔比 |
|---|---|---|
| Logic | **3711 / 8640** | 43% |
| — LUT / ALU / ROM16 | 3003(2642 LUT、361 ALU、0 ROM16) | — |
| — SSRAM (RAM16) | 118 | — |
| Register | **2203 / 6693** | 33% |
| — Logic Register as FF | 2194 / 6480 | 34% |
| — I/O Register as FF | 9 / 213 | 5% |
| — as Latch | **0** | 0% |
| CLS | 2850 / 4320 | 66% |
| BSRAM | **5 / 26**(4 SDPB + 1 pROM) | 20% |
| DSP | **4 / 10** | 40% |
| I/O Port | 18 / 71 | 26% |

**時序**:clk27 約束 27.000 MHz,實測 Fmax **44.776 MHz**,邏輯層數 9。
Setup 與 Hold 的 Total Negative Slack 皆 **0.000,違例端點 0 個**。

**功耗**:報告值 **36.609 mW**(工具估算,非量測;實測待補)。

`Logic` 是 Gowin 的合計欄 = LUT + ALU + ROM16 + SSRAM(RAM16),
不要當成 LUT 數引用。

## 排除的除錯電路代價

| | 量產 (MIRROR=0) | 錄製 (MIRROR=1) | 差 |
|---|---|---|---|
| Logic | 3711 | 3799 | **+88** (+2.4%) |
| LUT | 2642 | 2730 | +88 |
| Register | 2203 | 2262 | +59 |
| Fmax | 44.776 MHz | 41.087 MHz | −3.689 MHz |
| 功耗 | 36.609 mW | 37.694 mW | +1.085 mW |

鏡射只有 +2.4% 邏輯,兩個組態都遠高於 27 MHz 約束且零違例 —— 也就是說
**錄製時板上跑的行為與量產一致**,語料庫不因帶著鏡射而失效。

## 與 2026-08-08 那次的關係

08-08 的 3400 Logic / 2124 FF **已被取代**,不是因為那次有錯,而是之後改了:
`PER_CLKS` 改成 689 Hz、加了 ADS 暖機閘、`dog_fir_multi` 加飽和、
`halfduplex_ctrl` 加反向通道看門狗、`ttcgs_sys` 拉出封包器接點。
BSRAM 5 / DSP 4 / 零違例三項自始未變。

---

# 加入原始通道與板上判別器之後(2026-08-28 夜 ~ 08-29)

> **v2 與 v3 皆已作廢,以 v4 為準。** v2(Logic 4128 / Fmax 39.348 / 37.019 mW)
> 建置於 20:45,而冷開機修正是 21:15(`ads114s08_spi.v`)與 21:18(`ttcgs_board.v`)——
> **v2 是一個無法從內建 flash 獨立啟動的設計的數字**,不可引用。
> v2 的封存也沒有存 `ads114s08_spi.v` 的 as-built 副本。
>
> v3(Logic 4097 / Fmax 34.066)建置於 22:00,早於 23:00 的校正自癒修正
> (`zscore_flag_multi.v` 的 `VAR_CEIL` + `uncal`),同樣不是出貨設計。
>
> **教訓(當天犯了兩次):改完 RTL 就要重跑資源建置,且 archive 要存齊
> as-built 原始檔。** v4 的封存 `src/` 下有 12 個檔。

## v4(僅供追溯:早於 5σ 門檻)

封存 `impl_archive/2026-08-28_board_production_v4_calfix/`,`src/` 下 12 個 as-built 原始檔。

| 項目 | v1(無 raw/判別器) | **v4(出貨組態)** | 差 |
|---|---|---|---|
| Logic | 3711 | **4304 / 8640 (50%)** | +593 |
| — LUT / ALU | 2642 / 361 | 3046 / 550 | +404 / +189 |
| Register | 2203 | **2386 / 6693 (36%)** | +183 |
| BSRAM | 5 / 26 | **5 / 26** | 0 |
| DSP | 4 / 10 | **5 / 10** | +1 |
| Fmax | 44.776 MHz | **40.925 MHz** | −3.9(對 27 MHz 有 52% 餘裕) |
| Setup 違例 | 0 | **0** | — |
| 功耗 | 36.609 mW | **37.027 mW** | **+0.418 (+1.1%)** |

**「原始通道 + 板上力道無關判別 + 冷開機修正 + 校正自癒」四項合計:
+593 Logic(全晶片 6.9%)、+183 FF、+1 DSP、+0.42 mW。**

校正有效性檢查對 v3 只加 +207 Logic、+0.01 mW,而且 **Fmax 反而從 34.066
回到 40.925**(布局變異;兩者都遠高於 27 MHz 約束)。

## v3(僅供追溯:含冷開機修正,但無校正自癒)

封存 `impl_archive/2026-08-28_board_production_v3_coldstart/`,
`src/` 下含 11 個 as-built 原始檔(含 `ads114s08_spi.v`、`dog_coeffs.mem`、
`board.sdc`、`inausis.cst`)。

| 項目 | v1(無 raw/判別器) | **v3(出貨組態)** | 差 |
|---|---|---|---|
| Logic | 3711 | **4097 / 8640 (48%)** | +386 |
| — LUT / ALU | 2642 / 361 | 2829 / 560 | +187 / +199 |
| Register | 2203 | **2386 / 6693 (36%)** | +183 |
| BSRAM | 5 / 26 | **5 / 26** | 0 |
| DSP | 4 / 10 | **5 / 10** | +1 |
| Fmax | 44.776 MHz | **34.066 MHz** | −10.7(對 27 MHz 仍有 26% 餘裕) |
| Setup / Hold 違例 | 0 | **0** | — |
| 功耗 | 36.609 mW | **37.017 mW** | **+0.408 (+1.1%)** |

**「原始通道 + 板上力道無關判別 + 冷開機修正」三者合計:+386 Logic(全晶片 4.5%)、
+183 FF、+1 DSP、+0.41 mW。**

冷開機修正本身幾乎不花面積(對 v2 是 −31 Logic、+8 FF、+0.002 mW,
Logic 略減是佈局變異),但**把 Fmax 從 39.3 拉到 34.1** —— 仍遠高於 27 MHz 約束。

## 舊 v2 表(作廢,僅供追溯)

上面那份是**沒有**原始通道、**沒有**板上判別器、`SINGLE_CH=0` 的組態。
那已經不是要出貨的設計 —— 論文若要主張板上即時判別,就得報含它的數字。

v2 = `MIRROR=0`、`SYNTH=0`、`DEBUG_TAPS=0`、`SINGLE_CH=1`、dim12 載 raw、
`slide_detect` 接上。封存 `impl_archive/2026-08-28_board_production_v2_slide/`
(含 `ttcgs_board.v`、`dsp_chain.v`、`slide_detect.v` 的 as-built 副本)。

| 項目 | v1 | v2(作廢) | 差 |
|---|---|---|---|
| Logic | 3711 | **4128 / 8640 (48%)** | +417 (+11.2%) |
| — LUT / ALU | 2642 / 361 | 2860 / 560 | +218 / +199 |
| Register | 2203 | **2378 / 6693 (36%)** | +175 |
| BSRAM | 5 / 26 | **5 / 26** | 0 |
| DSP | 4 / 10 | **5 / 10** | +1 |
| I/O Port | 18 / 71 | 18 / 71 | 0 |
| Fmax | 44.776 MHz | **39.348 MHz** | −5.428 |
| Setup / Hold 違例 | 0 | **0** | — |
| 功耗 | 36.609 mW | **37.019 mW** | **+0.410 (+1.1%)** |

**整條「多留一段頻寬 + 板上做力道無關判別」的代價是 417 個 Logic(全晶片 4.8%)
與 0.41 mW。** Fmax 對 27 MHz 約束仍有 46% 餘裕。

其中判別器本身(兩個平方累加器 + 16 步序列乘法 + 接觸閘)只佔 +1 個 DSP;
`SINGLE_CH=1` 不花邏輯,`raw` 進 dim12 只是一個多工。

## DEBUG_TAPS

`dsp_chain.v` 的 `localparam DEBUG_TAPS` 把 `slide_detect` 的內部量(dim 14~17:
acc_hp、acc_fast、n_samp、當下 hp)送進封包,供主機逐樣本對照離線模型。
**引用資源數字時必須為 0。** 它是定位平方器有號性 bug 的工具 ——
那個 bug 讀了四次程式碼都沒找到。

---

# 量產組態 v5(2026-08-29,論文引用這個)

v4 之後又改了三處,全在 `zscore_flag_multi.v`:
`N_SQ` 9→**25**(3σ→5σ)、`VAR_FLOOR` 1→**0**、`cal_var` 保留 **4 位小數**。
(`synth_press.v` 的 LFSR 修正只影響 `SYNTH=1`,量產不含。)

封存 `impl_archive/2026-08-29_board_production_v5/`,`src/` 下 12 個 as-built 原始檔。

| 項目 | v1(無 raw/判別器) | **v5(出貨組態)** | 差 |
|---|---|---|---|
| Logic | 3711 | **4299 / 8640 (50%)** | +588 |
| — LUT / ALU | 2642 / 361 | 3077 / 514 | +435 / +153 |
| Register | 2203 | **2386 / 6693 (36%)** | +183 |
| BSRAM | 5 / 26 | **5 / 26** | 0 |
| DSP | 4 / 10 | **7.5 / 10 (75%)** | +3.5 |
| Fmax | 44.776 MHz | **40.477 MHz** | −4.3(對 27 MHz 有 50% 餘裕) |
| Setup 違例 | 0 | **0** | — |
| 功耗 | 36.609 mW | **37.011 mW** | **+0.402 (+1.1%)** |

**五項改動(原始通道、板上力道無關判別、冷開機修正、校正自癒、5σ 門檻)合計
+588 Logic(全晶片 6.8%)、+183 FF、+3.5 DSP、+0.40 mW。**

DSP 由 v4 的 5 增為 **7.5**:`cal_var` 保留 4 位小數把變異數加寬,
`N_SQ` 25 又讓門檻乘法變大,兩者一起多吃 2.5 個 DSP。
**10 個裡用掉 7.5,這是目前最緊的資源**,再加東西要先看這一欄。

3σ→5σ 那組對 v4 幾乎不花邏輯(−5 Logic、±0 FF、−0.016 mW,但 +2.5 DSP),
換來的是**十小時 2480 萬幀零誤觸發**;3σ 時同一塊板的靜止誤觸發在 0~16.94% 間跳。

---

# 量產組態 v6(2026-08-29 晚,論文引用這個)

v5 之後只改一處,在 `zscore_flag_multi.v`:把門檻的**常數**乘法
`($signed(N_SQ) * cal_var16) >>> 4` 換成依 `N_SQ` 設位元展開的移位加法樹。

## 為什麼會有這個浪費

`N_SQ` 是 `parameter`(編譯期常數 25),乘以常數本來不需要乘法器 ——
25 = 16+8+1,兩個加法器就結束。**但寫成 `*` 讓合成器推導出一顆 40×5 的真乘法器。**

v4→v5 那次 `N_SQ` 9→25(3σ→5σ)之所以吃掉 +2.5 DSP,就是這個原因:
常數從 4 位元變 5 位元,把推導出的乘法器推過了 macro 邊界。
**代價不是「5σ 比較貴」,是「常數乘法沒被削減」。**

寫法是依 `N_SQ` 的設位元展開(不是寫死 25),所以將來改 `N_SQ` 仍然正確。

## v6 資源表

| 項目 | v5 | **v6** | 差 |
|---|---:|---:|---:|
| **DSP** | **7.5 / 10 (75%)** | **5 / 10 (50%)** | **−2.5** |
| — MULT18X18 | 3 | 2 | −1 |
| — MULT36X36 | 1 | 1 | 0 |
| — MULTADDALU18X18 | 3 | **1** | **−2** |
| — ALU54D | 1 | 1 | 0 |
| Logic | 4299 / 8640 | **4374 / 8640 (51%)** | +75 |
| — LUT | 3077 | **3077** | **0** |
| — ALU | 514 | 589 | +75 |
| Register | 2386 / 6693 | **2386** | 0 |
| BSRAM | 5 / 26 | **5 / 26** | 0 |
| Fmax | 40.477 MHz | **37.301 MHz** | −3.176 |
| Setup / Hold 違例 | 0 | **0** | — |
| 功耗 | 37.011 mW | **37.051 mW** | +0.040 |

**用 75 個 ALU(全晶片邏輯 0.9%)換回 2.5 個 DSP macro(全晶片 DSP 25%)。**
LUT 一個沒動 —— 增加的全是進位鏈,移位加法樹就是加法器。
Fmax 掉 3.2 MHz 也是同一條 40 位元進位鏈,對 27 MHz 仍有 38% 餘裕。

## 行為等價性(已驗證,非推論)

40 位元語意下逐值比對 `(25*v)>>>4` 與設位元移位加法,
300,012 個值(邊界 + 全域隨機負到正)**零不符**。模 2^40 加法可分配,
所以兩式的位元樣式相同,`>>>4` 之後亦然。

因此 **v5 上量到的一切行為數據對 v6 有效**:十小時 2480 萬幀零誤觸發、
五次開機靜止 0.00%、偵測延遲 2.90 ms、延遲—振幅曲線。

**未做:v6 尚未燒進板子。** 板上是 v5 的位元流。要嚴謹得燒 v6 + 十分鐘靜止確認。

## 還沒動的:26×26 平方器(1 顆 MULT36X36)

`sq_op` 宣告成 26 位元,只因為三個來源裡最寬的 `s1_sum`(512 個 16-bit 累加
= 25 位元加符號)。但那個來源是校正收尾算 `sum²`,**開機後總共只發生 18 次**;
每樣本跑 584 次的另外兩個來源(`s1_x` 16 位、`s1_cmp` 17 位)只要 17×17,
一顆 MULT18X18 就夠。

**空隙是現成的**:`sum` 在 `cal_cnt` 到 512 時定案,而 finalize 要到下一次
輪到該維才用它 —— 中間至少一整個樣本週期(39,187 時脈),
26 週期的移位加法擠得進去一千五百次。

**沒做的原因**:18 個維度同時開始校正,會在同一個樣本週期內全部到期,
需要佇列(18×26 = 468 週期,仍塞得下)—— 那是一個 FSM 加 52 位元加法器,
且改的是行為路徑要重新驗證。**而 DSP 已經從 75% 降到 50%,不再是約束。**

**留給 2D 陣列版本**:10×10 時 flag engine 從 18 維變 300 維,
「把罕見但寬的運算排進空隙」屆時不是選項而是必要。

## 教訓

**FPGA 的 DSP 計數是面積/寬度配置,不是吞吐量配置。** 一顆乘法器閒置 99.9%
仍然佔著矽片。時間多(這裡 88% 空轉)換不到 DSP,除非**用窄的重複跑取代寬的**。
先查「有沒有把常數寫成 `*`」再考慮任何架構改動 —— 這次 2.5 個 macro
就是這樣白丟的。

## ⚠ MIRROR=0 完全沒有 UART 輸出(2026-08-29 燒錄時發現)

`ttcgs_board.v`:

```verilog
localparam MIRROR = 1'b0;
generate if (MIRROR) begin : g_mir
    frame_uart_mirror ... .uart_tx(uart_tx) ...
end else begin : g_nomir
    assign uart_tx = 1'b1;      // <-- 綁死高電位
end endgenerate
```

**論文報資源的那個組態,從主機端量不到任何東西。** 幀只走 Manchester 單線鏈路。
燒了 MIRROR=0 之後 `log_frames.py` 讀到 0 幀、`check_stream.py` 報「解析不到資料行」,
兩者都不是故障。

| 組態 | 用途 | 主機可量測 |
|---|---|---|
| MIRROR=0 | **論文報資源** | **否** |
| MIRROR=1 | **所有實測**(soak、語料庫、偵測延遲) | 是 |

**十小時 soak、30 筆語料庫、2.90 ms 延遲 —— 全部都是 MIRROR=1 錄的。**
論文若要並列資源與實測數字,必須說明兩者出自不同組態,以及鏡射的代價
(下表),否則等於宣稱一個量不到東西的組態產出了那些量測。

### v6 兩個組態

| 項目 | v6 量產 (MIRROR=0) | v6 錄製 (MIRROR=1) | 差 |
|---|---:|---:|---:|
| Logic | 4374 / 8640 (51%) | 4416 / 8640 (52%) | **+42** |
| — LUT / ALU | 3077 / 589 | 3119 / 589 | +42 / 0 |
| Register | 2386 | 2445 | **+59** |
| BSRAM | 5 / 26 | 5 / 26 | 0 |
| **DSP** | **5 / 10 (50%)** | **5 / 10 (50%)** | **0** |

鏡射不碰 DSP。封存:
`impl_archive/2026-08-29_board_production_v6_dspcut/`(資源)
`impl_archive/2026-08-29_board_recording_v6_mirror/`(實測,板上燒的是這個)

v5 時代的鏡射代價是 +88 Logic / +59 FF / +1.085 mW;v6 降到 +42 Logic,
因為常數乘法改寫後佈局變了(FF 與 DSP 兩項不變)。

### 燒錄實測(2026-08-29 20:35)

`flash.ps1 -Fs board_v6_mirror.fs -Flash` → **`Verify Failed at 0` 照舊出現,是假警報**。
真正的證據是 **User Code 隨 bitstream 改變**:MIRROR=0 版 `0x0000468B`、
MIRROR=1 版 `0x0000FA07`。燒完 30 秒健檢:**690 fps、badCRC 0、resync 0、
dead map 0x3FFF8**(只有 ch0 三維活著,符合單通道組態)。
