sigmanssery/INAUSIS/DATA/SESSION_2026-08-28_LEDGER.md

# 2026-08-28 當日總帳

一天下來多次「立論 → 推翻」,以下把**現在成立的**和**已撤回的**分開。
每一項都註明證據與所在文件。**引用任何數字前請先看本表。**

---

## A. 成立(有證據、且已複現或不依賴人手)

| 結論 | 數字 | 證據 | 文件 |
|---|---|---|---|
| 前端時序解析度 | 上升/持續 **1 樣本 = 1.45 ms**,重複 sd **0.00** | 合成刺激經真實 RTL,32 步掃描 ×3~4 輪 | `FRONTEND_RESOLUTION` |
| 按壓間載荷解析度 | **約 5 counts** | 同上 | `FRONTEND_RESOLUTION` |
| 峰值解析度 | **約 15 counts = 0.05%** | 同上 | `FRONTEND_RESOLUTION` |
| 人手的變異 | 上升 sd **43 ms**、時長 sd 47.7 ms、峰值 sd 11.9% | 語料庫 C 類 48 次真實按壓 | `FRONTEND_RESOLUTION` |
| → **儀器比被測現象細 30 倍** | | | |
| 靜止誤觸發 | **0 幀 / 24,804,408 幀(10 小時)** | 真感測器、5σ、含市電劣化時段 | `SOAK_2026-08-29_10h` |
| 偵測延遲(真實接觸) | **2 樣本 = 2.90 ms** | 3σ 115 事件 + 5σ 24 事件,中位相同 | `DETECTION_SPEC` |
| 偵測下限 | **沒有硬下限**,55 counts(靜止 sd 的 1.5 倍)仍 100% 偵測 | 合成刺激,雜訊已修正 | `DETECTION_SPEC` |
| 延遲—振幅曲線 | 14025→9.4 ms、880→21 ms、220→41 ms、**55→100.9 ms** | 同上,重複緊(55 counts 那列 69/70/68/70) | `DETECTION_SPEC` |
| 濾波器群延遲 | DoG_fast 能量重心 **13.4 ms**(核為因果前載,非置中對稱) | 由 `dog_coeffs.mem` 直接算 | `DETECTION_SPEC` |
| 鏈路 | **badCRC 0、丟幀 0 / 2480 萬幀** | 主機端與檔案端獨立算出一致 | `SOAK_2026-08-29_10h` |
| 基線漂移 | **−0.57 counts / 10 小時** | 逐小時均值 | `SOAK_2026-08-29_10h` |
| 門檻穩定性 | 5σ 下**五次開機皆 0.00%**;10 小時 soak 中 d0 雜訊漲 46%、市電佔其功率 39% 時**仍零誤觸發** | 開機 ×5 + 10 h soak | `DETECTION_SPEC` / `SOAK` |
| 靜止雜訊基準 | d12 var **672.76**(sd 25.94)、d2 var **4.65** | 60 秒整段、不切段不去均值 | `DETECTION_SPEC` |
| 冷開機修復 | dead 0x3FFF8、d12 628 Hz、`dropped 0 stale` | 燒 flash + 實際拔插 | `COLDSTART` |
| 校正自癒 | 重置後 uncal 持續 **1024 幀 = 恰好 2×CAL_N** | 錄製中按 S2 直接觀測 | `DETECTION_SPEC` |
| 量產資源 v4 | Logic **4304/8640**、Fmax **40.925 MHz**、違例 **0**、**37.027 mW** | 封存含 12 個 as-built 原始檔 | `RESOURCES` |
| 鏈路完整性 | 186 萬幀、遺失 **0.0106%** | 76 個檔中 75 個全乾淨 | `SLIDE_DETECT` |
| 市電耦合路徑 | **接觸傳導**:手離開 3.5% / 懸空 9.5% / 輕放 **85.8%** | 三段 30 秒完整靜態 | `SLIDE_DETECT` |

## B. 已撤回

| 曾主張 | 為什麼垮 | 現在的說法 |
|---|---|---|
| 五類手勢分類、十對全分開 | **類別與錄製時段完全混淆**;力道解釋 fast/g3 **83%** 的變異(r=−0.912) | 力道配平後 C/D/F/G 只差 8%;**那批語料庫量的是手** |
| C 與 G 可分 | 定義差異(按壓間手指在不在表面)只產生 **0~3 counts**,前端要 5 counts | **落在解析度以下**,任何演算法都救不了 |
| 滑動/按壓判別 94% | **第二場斷電換序 → 48.6%**(按壓側 100% 複現,滑動側 92%→39%) | H 量的是 **stick-slip**,不是類別;平順的滑動就是一次按壓 |
| 偵測延遲 5.81 ms、下限 440~880(**舊合成刺激版**) | LFSR 每樣本只移一位 → 相鄰樣本共用 6/7 位元 → 不是白雜訊,低頻缺 60 倍 | **已修並重測**:每樣本推進 8 步;新曲線見成立區 |
| 「dim2 free-run 31~57%」 | 歸因錯誤 —— 混了校正窗污染與產生器**刻意**施加載荷時的合法觸發 | 修正後 12 個零載荷週期全部 0% |
| 「真實雜訊是 1/f,需要補低頻」 | 10 小時 soak 實測:0.1~30 Hz 平坦到 ±0.4 dB,**是白的** | 異常在合成端;丟掉一整晚在解不存在的問題 |
| dim0 靜止誤觸發 0.606% | 拿語料庫「前 3 秒」當靜止,而有些檔一開始就在滑 | **確定沒碰的錄音是 0 幀** |
| 市電佔靜止雜訊 61% | 那段錄音手在附近 | **手離開時只有 3.5%** |
| 真實 raw sd = 44.2 | 同上,傍晚手在附近錄的 | **25.94** |
| 量產 v2(4128)/ v3(4097) | 各自早於冷開機修正、校正自癒 | **以 v4 = 4304 為準** |

## C. 排除的假設(不必重試)

滑動判別垮掉的原因**不是**:力道(配平後 97% vs 34%)、時長(r=−0.05, n=126)、
韌體(dead map 兩場相同)、市電(挖掉頻格後 d 只從 2.56 降到 2.42)。

開機間門檻擺盪的原因**不是**:`VAR_FLOOR`(1→0 無效)、`cal_var` 量化
(保留 4 位小數無效)。真因是操作點選在 3σ。

## D. 未完成

* **原始通道在 28% 的接觸幀削頂**(撞 32767)。已驗證不影響 H(d 1.16→1.13),
  但峰值附近的高頻內容確實被削掉;要保留需改 `R_div` 或 PGA,會動到所有校正
* **市電比昨夜基準高十倍**(soak 第 2 小時 37.1% 對昨夜 3.5%)。
  leading hypothesis 是 **MRE 順應層**,未測試 —— 需有/無 MRE 各錄 60 秒對比
* 實測功耗(現為工具估算 37.027 mW)
* `VAR_FLOOR` 的原理性修法:用「原始輸入是否曾變化」判斷 dead,
  而非用濾波後的變異(現行只有 4 倍餘裕)
* `CONTACT_THR = 6000` 對輕觸覆蓋不足(舊 E 類振幅曾低到 5757)

## E. 方法論教訓(當天各犯 2 次以上)

1. **同一場的乾淨結果撐不到第二場。** 早上垮在力道、晚上垮在執行質地。
   → 斷電 + 換類別順序的第二場是必要的,不是可選的
2. **靜止基準只能用確定沒碰過的錄音。** 犯了兩次(挑 `VAR_CEIL`、算誤觸發率)
3. **量低頻雜訊時任何分段去均值都會刪掉目標。** 真感測器 raw sd 因此被量成 25.4
4. **改完 RTL 要重跑資源建置**,archive 要存齊 as-built 原始檔。犯了兩次
5. **判定建置成功要看錯誤數,不要看 `.fs` 存不存在**
6. **RTL 數值不對時,把中間量接到空 dim 上比對** ——
   平方器的有號性 bug 讀了四次程式碼都沒找到,接出來一次就定位
7. Verilog **串接永遠是無號的**;`~x + 1'b1` 會把整個三元式降為無號

## F. 目前狀態

* 板子:`board_final.fs`(= v7,真感測器、5σ、校正自癒、冷開機修正)燒在 **SRAM**;
  **Flash 裡是 `board_coldstart.fs`**(較舊,無 5σ 與校正自癒)
* 原始碼:錄製組態(`SYNTH=0 / MIRROR=1 / DEBUG_TAPS=1`、`N_SQ=25`、
  `VAR_FLOOR=0`、`VAR_CEIL=20000`)
* 合成產生器已還原為純白雜訊,整形程式碼完全移除
