sigmanssery/INAUSIS/DATA/SESSION_2026-08-29_LEDGER.md

# 2026-08-29 / 08-30 當日總帳

> 那天推翻與修正的東西很多。這份把**成立的 / 已撤回的 / 失敗的 / 未完成的**分開列。
> **引用當天任何數字前先看這份。**

---

# 一、成立(已驗證)

## 1. v6:常數乘法強度削減,DSP 7.5 → 5

`zscore_flag_multi.v` 的 `($signed(N_SQ) * cal_var16) >>> 4` 改成依 `N_SQ` 設位元
展開的移位加法樹。`N_SQ` 是 `parameter`(=25),**寫成 `*` 讓合成器推導出一顆
40×5 的真乘法器**。

| | v5 | **v6** | Δ |
|---|---:|---:|---:|
| DSP | 7.5/10 (75%) | **5/10 (50%)** | −2.5 |
| — MULTADDALU18X18 | 3 | 1 | −2 |
| Logic | 4299 | 4374 | +75(全是 ALU,LUT 一個沒動) |
| Fmax | 40.477 | 37.301 MHz | −3.2(對 27 MHz 仍 38% 餘裕) |
| 功耗 | 37.011 | 37.051 mW | +0.040 |

**行為位元相同**:40 位元語意下 300,012 個值(邊界 + 全域隨機)零不符。
所以 v5 上量到的 soak / 5σ / 延遲數據對 v6 有效。

**`DSP 7.5` 已作廢。** 之前以為那是 5σ 的代價,錯了 —— 5σ 本身幾乎不花東西。

## 2. MIRROR=0 完全沒有 UART 輸出(結構性)

`ttcgs_board.v` 的 `MIRROR=0` 分支是 `assign uart_tx = 1'b1;`。
**論文報資源的組態從主機端量不到任何東西。**

- 十小時 soak、30 筆語料庫、2.90 ms 延遲 —— **全部是 MIRROR=1 錄的**
- 燒 MIRROR=0 後 `log_frames.py` 讀 0 幀、`check_stream.py` 報「解析不到資料行」,
  **兩者都不是故障**
- v6 鏡射代價:+42 Logic / +59 FF / **DSP 不變**

**論文並列資源與實測時必須說明兩者出自不同組態。**

## 3. 一次性校正失效的根因(可計算)

| | 自相關時間 τ | CAL_N=512 的有效獨立樣本 |
|---|---:|---:|
| d0 DoG_fast | 3 幀 | 170 |
| d1 DoG_slow | 13 幀 | 39 |
| **d2 G_s3** | **84 幀** | **~6** |

6 個有效樣本估變異數,χ² 六自由度給出 σ 估計值 **0.52×~1.45×**,
即標稱 5σ 實際落在 **2.6σ~7.3σ**。

實測六次開機:**低於 0.007% ~ 0.083%**,與模型吻合(0.083% 對應約 3.34σ)。

**這是 CFAR 的標準失效**:參考窗短於雜訊相關時間。文獻佐證見第五節。

## 4. 靜止分佈是高斯的 —— 錯的是估計器不是模型

d2 的 kurtosis **2.9**(高斯=3)、skew 0.00。以本次錄製自己的 mean/sd 計算:

    4σ  實測 7.26e-05  vs 高斯 6.33e-05  = 1x
    5σ  實測 0.000e+00 vs 高斯 5.73e-07  = 0     <- 413,512 幀一次都沒超過

**分佈完全正常,而硬體觸發了 343 次** → 門檻本身設錯,不是尾巴厚。
(ConsensusAI 提示的「厚尾」假說在我們的資料上被排除。)

## 5. v8:滾動基線 + CFAR 守衛區,雙向驗證通過

作法:保留一次性校正當**初值**(開機 0.74 秒武裝的特性不變),之後用
指數遺忘持續更新。關鍵是 `cmp_sq` **本來就是**比較在算的偏差平方,
所以不需要第二顆乘法器、不動管線。守衛區 128 幀(> τ=84),
觸發時凍結更新,接觸自己的能量進不了雜訊估計。

| | v6 一次性 | **v8 滾動+守衛** |
|---|---:|---:|
| 十分鐘靜止 | 343 / 413,512 (0.0829%) | **0 / 413,516** |
| 五輪開機全距 | 0.0096 | **0.0000**(五輪全 0) |
| 按壓偵測 | — | **19 / 19**,三維每次都亮 |
| 偵測延遲 | — | **0 幀 ×17 / 1 幀 ×2** |
| d2 靜止 sd | 2.170 | 2.332 |

**d2 的 sd 兩邊一樣 → 不是環境變安靜,是門檻行為變了。**
按壓段前後(<18s、>95s)各 0 觸發。

代價:Logic 4416→4893、FF 2445→2641、**DSP 50%→70%**(52 位元累加器吃 3 個 ALU54D)。

## 6. 偏態 / 單邊窗:全部比對稱高斯差(對照組已驗證)

確定性網格、所有窗族共用搜尋箱、論文的阻帶定義(f ≥ 0.2 f_s)、
通帶 2% 內、質心 ±0.3:

| 窗族 | 阻帶 | h[0]/峰值 |
|---|---:|---:|
| **none(對照組)** | **25.54 dB** | 0.341 |
| skew | 20.66 | 0.114 |
| tukey | 21.90 | 0.000 |
| expo | 21.61 | 0.000 |

對照組命中目標 25.44 dB → 搜尋箱有效。**三種單邊窗全輸 3.6~4.9 dB,
即使把原點殘值壓到零。** 機制:漸降買阻帶的代價是過渡帶變寬,
而通帶被鎖死時它無處可花(AVANZATO 2023 獨立佐證)。

## 7. 出貨核被獨立重現

擬合出貨 `dog_coeffs.mem`:**ξ=5.300、σ₁=2.200、σ₂=8.801、σ₃=84.957**,
與論文的 5.3 / 8.8 / 85 完全一致。重建後阻帶 **25.43 dB == 出貨 ROM 25.43**。
階躍下衝 **18%**,論文寫 17%。**論文的核設計現在是被驗證過的,不只是宣稱。**

---

# 二、已撤回

| 撤回的 | 正確的 |
|---|---|
| `DSP 7.5` 是 5σ 的代價 | 是常數乘法沒被削減;5σ 幾乎免費 |
| **5σ 給出零誤觸發** | **跨開機 0~0.083%**;十小時 soak 是「校正落點好」的單次開機 |
| 偏態在等延遲下多 13.3 dB | 浮動阻帶起點造成的假象;固定定義下單調變差 |
| 論文 §III-C 與 G_s3 不一致 | **論文是對的且已明講**「σ₃ is untouched by the delay」 |
| 343 次誤觸發是熱機瞬態 | 觸發平均散在十分鐘,每分鐘 d2 均值只動 0.5 counts |
| Gabor 極限是偏態失效的原因 | 推理錯(Gabor 講集中度不是旁瓣),結論碰巧對 |
| DoG_slow 阻帶只有 21.0 dB | 那是我自訂度量;論文定義下是 **28.5 dB** |

---

# 三、失敗(記下來避免重犯)

## v7 滾動基線第一版:定點移位的不對稱捨入

```verilog
thr_roll = s2_thr + ((roll_tgt - s2_thr) >>> 12);   // 錯
```

門檻約 **118**,`>>> 12` 是除以 4096:**正差變 0、負差變 −1**
(算術右移向 −∞ 取整)。門檻每樣本至少掉 1,**0.17 秒歸零**,
之後 **88~99% 的幀觸發**(五輪實測)。

**修法**:累加器加寬 ROLL_K 位當小數,被移位的是 `roll_acc`(約 4.8e5)
而非三位數的差值;向下取整讓估計略偏高,失效方向安全。

**教訓**:算對設計意圖不等於算對算術。**選移位量前先看被移位的數有多大。**
(與「把編譯期常數寫成 `*`」同類,同一天犯兩次。)

---

# 四、文獻定位(ConsensusAI,七題)

| 主張 | 共識 | 對論文的影響 |
|---|---|---|
| 力道是觸覺手勢分類的混淆變量 | 是,但**力匹配後類別差異不會完全消失** | **§IV-F 要改寫**(見下) |
| DoG 中心-周邊 = 預測編碼 | Yes 75%,SRINIVASAN 1982 | 重新框定安全,可加引用 |
| 自相關使短窗變異數估計不可靠、誤警率暴增 | 強共識(HU 2019、MORRÁS 2022) | **我們的 bug 是已知原理沒遵守** |
| 自適應門檻優於一次性校正 | **Yes 100%(11 篇)** | 支持 v8 的方向 |
| 單邊截斷高斯毀掉阻帶 | 是(SCHMID 2022) | **§III-C 要降級成已知原理的應用** |
| 黏滑摩擦而非滑動產生高頻特徵 | 強共識;FANG 2025:**光滑表面才有黏滑,粗糙表面全滑動** | **直接解釋我們的複現失敗** |
| 操作者變異限制手做刺激能量到的解析度 | 是;CHAUDHURI 2017:**跨操作者 17~37 ms** | §IV-E 要改成已知地板的應用 |

**§IV-F 的新寫法(比原版強)**:文獻能「救回來」的手段 —— 剪力(CHOI 2022:
66%→74%)、切向分量(TAMURA 2024:29% vs 21%)、光流(ZHONG 2025:+9%)——
**我們的單軸法向力前端全都沒有**。所以正確主張是「單一法向力通道在力匹配後
無法分開這些類別」,而不是「觸覺手勢分類會被力道毀掉」。**有引用撐、更難反駁,
而且順勢指出 2D 陣列的價值在剪力與空間資訊。**

---

# 五、未完成

| 項目 | 狀態 |
|---|---|
| 合成下限掃描驗證 v8 | **未做** —— 手做不出分級(19 次按壓峰值比 0.61),下限只能用 `SYNTH=1` 量 |
| 階梯導頻(門檻見證者) | 未做 —— 是驗證「門檻沒膨脹」的必要儀器 |
| 跨尺度一致(可選模式) | 未做 —— 資料顯示可收掉 99% 單維假象,但會關掉 G_σ3 的握持偵測 |
| DSP 瘦身 | 未做 —— 52 位元累加器保守過頭;或改隨機分位數追蹤器 |
| 功耗實測 | **待料(約 3 週)**;只需量**獨立供電的感測 PCB** 一次來驗證估算方法 |
| 論文修訂 | 未做 —— `01_paper/v25_revisions.md` 已寫好,但需併入本日結果與七則引用 |
| 可變電阻端到端下限 | 待料 —— AD5254(四通道 256 階);**注意訂單寫 ADS5254 是 TI 的 ADC,要核對** |

## 硬體筆記

- **`Verify Failed at 0` 是假警報**(再次確認)。真憑據是 **User Code 隨 bitstream 改變**:
  MIRROR=0 `0x468B`、MIRROR=1 `0xFA07`、v8 `0x858A`
- 板上目前燒的是 **v8(`board_v8_roll2.fs`,滾動基線 + 守衛)**
- 封存:`impl_archive/2026-08-29_board_production_v6_dspcut/`(資源)、
  `impl_archive/2026-08-29_board_recording_v6_mirror/`(實測)

## 功耗的結構(不需新量測就能寫進論文)

    靜態(漏電)  26.73 mW   72%
    動態          10.33 mW   28%

**「37 mW 前端」裡 72% 是一顆遠大於需求的 FPGA 的靜態漏電。**
真正屬於這個設計的是 10.3 mW —— 這對「未來 ASIC 化」是直接支撐。
