sigmanssery/INAUSIS/DATA/SLIDE_DETECT_2026-08-28.md

# 板上即時的滑動/按壓判別(2026-08-28)

> ## ⚠ 分類主張沒有複現 —— 引用前先看本文最後一節
>
> |  | 第一場 | 第二場(斷電換序) |
> |---|---|---|
> | 按壓 | 16/16 **100%** | 16/16 **100%** |
> | 滑動 | 34/37 **92%** | 35/89 **39%** |
> | 總計 | **94%** | **48.6%** |
>
> **下文的 94%、92%、d=2.56 全部只在第一場成立。** 按壓側複現,滑動側塌掉。
> 排除了力道、時長、韌體;真因是 **H 量的是 stick-slip 而不是類別** ——
> 平順的滑動在高頻上就是一次按壓。
> **量測本身是對的**(板子/累加器/離線三方逐事件差 1% 內),垮的是主張。

## 判別量

    H = RMS(raw - G_s1) / RMS(DoG_fast)      在一次接觸期間累加

分子分母是**同一訊號的兩個頻帶**(G_s1 轉角以上的殘差,與 14~70 Hz 的 DoG_fast),
接觸振幅自然對消。這是它力道無關的原因,也是它和 `DoG_fast / G_s3` 的關鍵差別 ——
後者對力道的相關是 **−0.91**,分母是隨力道長的近直流量,那正是毀掉 08-28
手勢語料庫的陷阱(見 `FINDINGS_2026-08-28_force-confound.md`)。

## 實作(`slide_detect.v`)

    接觸中    acc_hp   += (raw - G_s1)^2 >> 8
              acc_fast += DoG_fast^2     >> 8
    接觸落緣  acc_hp * 256  >  acc_fast * thr_q8   ->  滑動

* `G_s1`、`DoG_fast`、`G_s3` 都是 `dog_fir_multi` 現成的輸出,只多一個減法
* 比較用 16 步移位加法,一次事件才算一次(樣本間有 39187 個時脈)
* `thr_q8` 是暫存器,可經現有反向通道重調
* 判定走 status 位元組:bit1 = 上次接觸判為滑動,bit2 = 目前接觸中
* 代價 Logic 4183/8640、Register 2437、DSP 4→5、**Setup 違例 0**

**必須用接觸閘住。** 靜止時 H 是 5.02~6.30,**比兩類都高**(分子分母都只有雜訊),
沒有閘的話比較器會對空無一物的感測器持續報「滑動」。實測靜止 10 秒、6997 幀,
status 全為 1,零誤判。

## 第一場驗證(53 個事件,4 筆錄音)—— 未能複現,見文末

    按壓  16/16 = 100%    (零次誤判成滑動)
    滑動  34/37 =  92%
    總計  50/53 =  94%    <- 樣本外,門檻取自另一場

三方一致:**板子的判定、板子累加器的值、離線重算,逐事件比值差在 1% 以內**
(2.92/2.91、6.90/6.87),樣本計數逐事件完全相同。

    按壓 比值 2.65 ~ 3.26   中位 3.08
    滑動 比值 3.20 ~ 7.55   中位 5.84

三次錯的都是滑動被判成按壓,而且都是**短滑動**(短滑動中位 4.70 對長滑動 5.89)。
滑得短則持續的高頻內容少,物理上合理。

**門檻**:3.77 來自另一場的 17 筆力道掃描,在本批(第一場)得 94%。兩類在本批
的範圍是 2.65~3.26 與 3.20~7.55,故預設改為 **3.30**。
3.27 能得 98% 但那是樣本內。

> **⚠ 這兩個門檻在第二場都不成立**(見文末)。3.30 是有紀錄的起點,
> 不是驗證過的設定。

## 效力邊界

* 單一受試者、單一場、單一感測器;仍缺斷電換序的複現
* 兩類在本批有一個事件重疊(按壓最大 3.26 對滑動最小 3.20),沒有門檻能到 100%
* 只在 SRAM

## 兩個 Verilog 有號性陷阱(同一晚踩兩次)

1. `synth_press` 的 LFSR:**串接永遠是無號的**,`>>>` 因而是邏輯右移,
   雜訊在半數樣本變 +32700 而非 −64,把 sample 的符號位打翻。
2. `slide_detect` 的平方:`~hp + 1'b1` 混入無號的 `1'b1`,**整個三元運算式被降為
   無號**,負的 `hp` 被當 18 位元無號數平方(hp=−53 變 262091),acc_hp 灌大兩萬倍,
   所有判定被釘在「滑動」。**有號數自乘本來就是正的,那段轉換是多餘的且正是 bug 來源。**

第 2 個**不是靠讀程式碼找到的** —— 是把 `hp`、`n_samp`、累加器逐一接到空維度
(dim 14~17)上比對才定位:`hp` 逐幀正確、`n_samp` 逐事件正確,才把範圍縮到平方那步。
在那之前猜了四五個方向全錯。**下次遇到 RTL 數值不對,直接把中間量接出來,不要用讀的。**

---

# 市電耦合的對照(2026-08-28 夜)

## 市電從身體進來,不是從電源

三段各 30 秒完整靜態錄音(相位連續,不切段拼接):

| 條件 | d12 sd | 60 Hz 高於底噪 | 市電佔總雜訊功率 |
|---|---|---|---|
| 手離開 30 cm | 24.9 | 17.9 dB | **3.5%** |
| 手懸空 2 cm | 25.9 | 22.9 dB (+5.1) | 9.5% |
| 手指輕放 | **79.0** | 41.0 dB (**+23.1**) | **85.8%** |

手真的碰到,雜訊 sd 從 24.9 跳到 79.0(3.2 倍),其中 86% 是市電諧波。
懸空只多 5.1 dB,所以主要不是電容耦合,是**接觸傳導**。

**外接天線參考通道沒有用** —— 天線量到的與手指注入的不相關。要治是接地或電池供電。

> 更正:先前記錄「市電佔靜止雜訊 61%」是拿一段手在附近的錄音算的。
> 手確實離開時只有 3.5%。

## H 是否只是在量市電耦合?否

60/120/180/240 Hz 全落在 H 的分子頻帶內,而滑動的接觸面積更大,理應耦合更多 ——
這是對 H 的直接威脅。把市電頻格(±6 Hz)整個挖掉重算:

    類別   n    原始比值            濾掉市電後          hp 中市電佔比
    按壓  16   3.22 [1.68~4.61]   3.10 [1.64~4.41]       6%
    滑動  33   6.16 [3.62~8.64]   5.56 [3.38~8.15]      15%
    Cohen d      2.56                2.42

滑動確實多耦合 2.5 倍市電,但**扣掉之後效應量只從 2.56 降到 2.42**,
分開的主體不是市電。

注意此處 d=2.56 是**逐事件**(n=49),對應板上判別器的實際情境與 94% 的正確率;
先前 `RAWCHANNEL_2026-08-28.md` 報的 d=5.15 是**逐檔案彙總**(n=17)。
兩者不衝突,但不可混用。

---

# 兩個實務限制(2026-08-28 夜的稽核)

## 1. 接觸門檻對輕觸的覆蓋不足

`CONTACT_THR = 6000` 對雜訊極安全 —— 靜止基線 1790、d2 的 sd 只有 2.4,
門檻在基線之上 1750 個 sd。但對**輕觸**的餘裕只有 1.6 倍:

    按壓 n=16  事件峰值 13091 ~ 28403(門檻的 2.2 倍起)
    滑動 n=37  事件峰值  9534 ~ 32119(門檻的 1.6 倍起)

**協定裡舊版 E(輕撫)的接觸振幅曾低到 5757 —— 在門檻之下,判別器完全看不到。**
若要涵蓋輕撫,門檻需降到 3000 上下。

降門檻原本的疑慮是:靜止時 H = 5.02~6.30(比兩類都高),接觸越輕比值可能越往
那個值漂而誤判成滑動。**實測不成立**:

    比值 vs 事件峰值   按壓 r = +0.45   滑動 r = -0.05
    低振幅按壓(峰值<20000)n=7 比值中位 2.91
    高振幅按壓          n=9 比值中位 3.12

低振幅的比值反而**略低**,沒有往 5~6 漂。所以在**已測範圍內**降門檻是安全的。

**但已測的最低事件峰值是 11301(|g3| 8365),再低沒有資料。** 若把門檻降到 3000,
峰值 3000~11000 那段的比值可靠性是未經驗證的,需要專門錄一批輕觸來確認。

## 2. 鏈路完整性(45 分鐘、186 萬幀)

    76 個錄製檔中 75 個完全無時戳跳號
    總計 1,864,381 幀,遺失 197 幀 = 0.0106%
    且全部集中在單一檔案的一次 0.29 秒中斷

開頭的陳舊前綴不計入(那是主機端緩衝,已於 `log_frames.py` 解決)。

---

# 第二場複現:失敗(2026-08-28 22:12)

斷電冷開機 + 類別順序倒過來 + 交錯錄製(slide1, press1, slide2, press2)。

|  | 第一場 | 第二場 |
|---|---|---|
| 按壓 | 16/16 = **100%** | 16/16 = **100%** |
| 滑動 | 34/37 = **92%** | 35/89 = **39%** |
| 總計 | 50/53 = 94% | 51/105 = **48.6%** |
| Cohen d(逐事件) | 2.56 | **0.76** |
| 按壓 H | 2.65~3.26 中位 3.08 | 2.03~3.25 中位 3.08 |
| 滑動 H | 3.20~7.55 中位 **5.84** | 1.67~7.23 中位 **3.12** |

**按壓完全複現,滑動整個塌到與按壓重疊。**

## 排除的解釋

**不是力道。** 配平 |g3| 11000~24000 之後:第一場 n=29 H 中位 5.84、判對 97%;
第二場 n=64 H 中位 3.11、判對 34%。同力道下差近兩倍。

**不是時長。** 滑動的 H 對事件時長 r = −0.05(n=126)。兩場的時長分布相近
(中位 351 vs 299 ms)。第二場事件數多是因為間隔短,不是每次短。

**不是冷開機或韌體。** dead map 兩場都是 0x3FFF8,按壓那一半逐事件複現。

## 真正的原因:滑動的「質地」不是穩定屬性

力道配平的滑動事件,hp 頻譜第二場 / 第一場:

    0-20 Hz    1.81x     <- 低頻變多
   20-60 Hz    0.96x
  100-150 Hz   0.36x     <- 高頻掉到三分之一
  150-292 Hz   0.40x

第二場滑得**更平順、黏滑摩擦更少**。

**H 量的不是「滑動 vs 按壓」,是「接觸有沒有 stick-slip」。** 同一個「滑動」指令
在物理上可以做出兩種完全不同的接觸,而 H 只看得見富含 stick-slip 的那一種。
平順的滑動在高頻上就是一次按壓。

## 效力結論

* **`slide_detect` 的 94% 不可引用。** 那是單場結果,第二場為 48.6%。
* 按壓側穩定(兩場皆 16/16,H 分布重疊)—— 誤判成滑動的情形從未發生。
* H 本身是穩健的量(雜訊餘裕 6 倍、輕觸餘裕 4 倍、力道 r≈0),
  **問題不在量測,在被量測的物理量不是類別的穩定標記。**
* 若要繼續這條路,需要**獨立控制或量測 stick-slip**(滑動速度、表面粗糙度、
  皮膚狀態),否則「滑動」不是一個定義良好的類別。

同一個教訓第二次出現:**同一場的乾淨結果撐不到第二場。** 早上垮在力道,
今晚垮在執行質地。任何單場結果在複現之前都不該寫進論文。
