sigmanssery/INAUSIS/PCB/V2/README.md

# PCB / V2 — not fabricated

V2 was designed and then superseded by [V3](../V3) before anything was ordered.
No Gerber, BOM, or pick-and-place exists, and none is coming.

The folder exists so that the gap in the numbering is explained rather than
looking like something went missing. Everything V2 was meant to address is in
V3, which was started from the V1 layout rather than from V2.
