sigmanssery/INAUSIS/CODE/V1/01_golden_model/ttcgs_golden.png

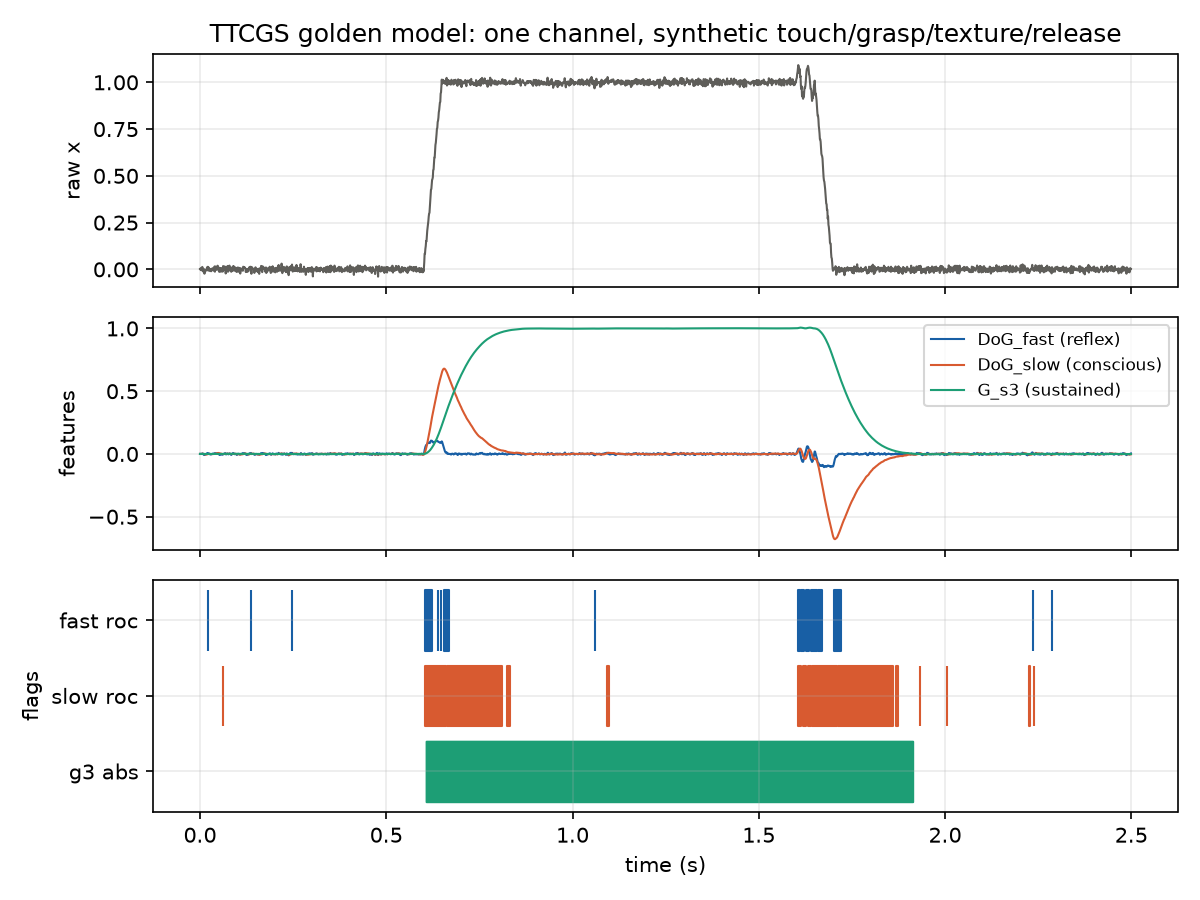
CODE/V1/01_golden_model/ttcgs_golden.png
