sigmanssery/INAUSIS/DATA/figs/fig_detection_floor.png

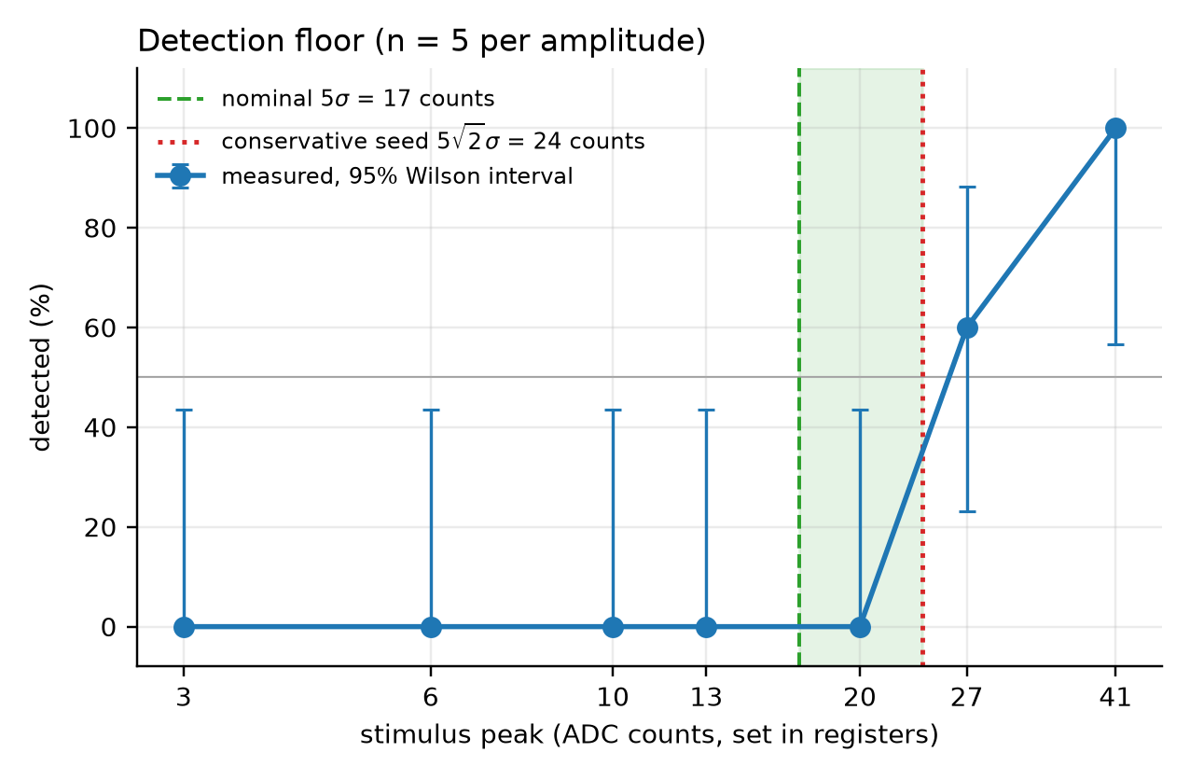
DATA/figs/fig_detection_floor.png
