sigmanssery/INAUSIS/DATA/figs/fig_guard_lock.png

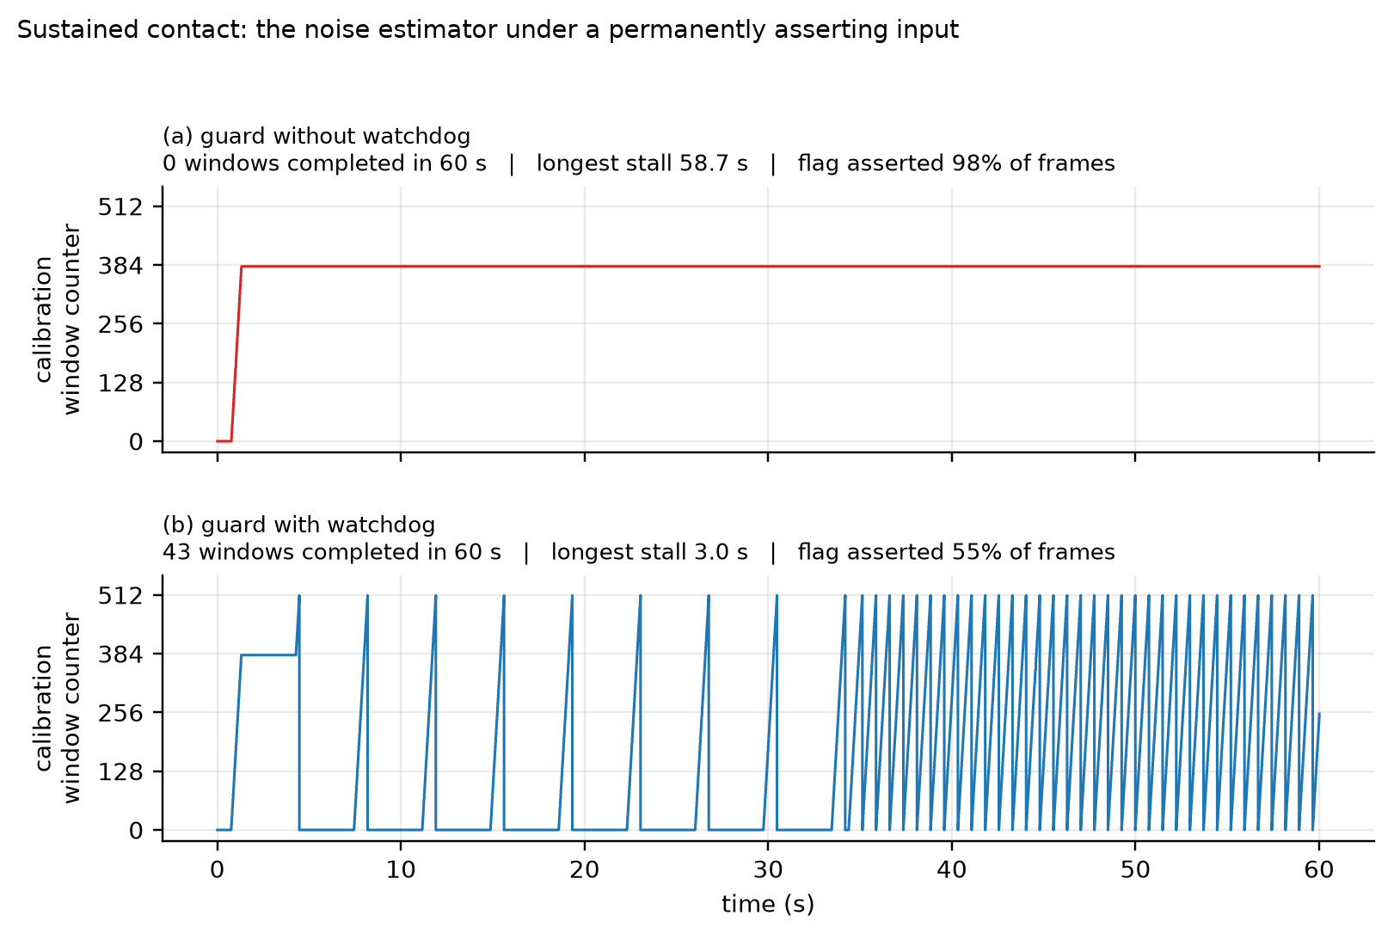
DATA/figs/fig_guard_lock.png
