sigmanssery/INAUSIS/DATA/figs/fig_resolution_vs_operator.png

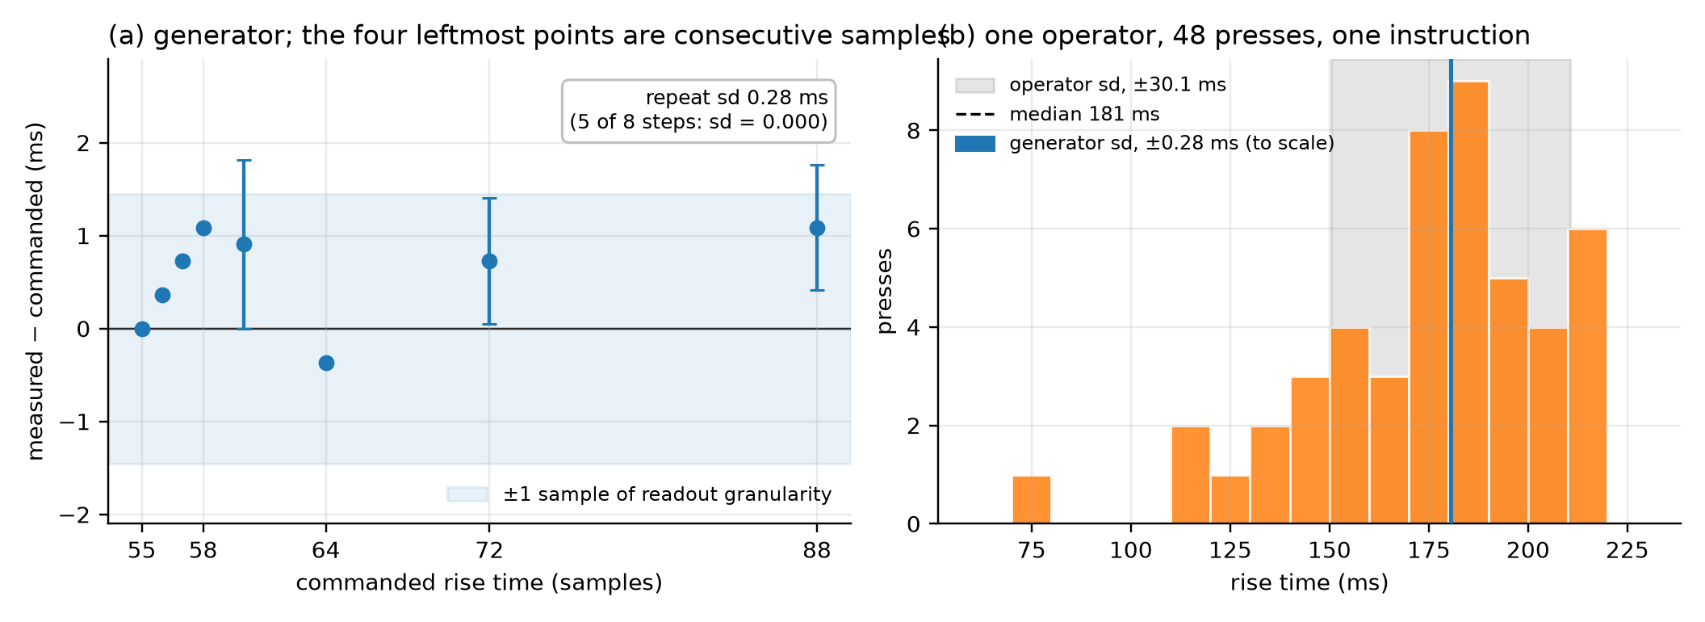
DATA/figs/fig_resolution_vs_operator.png
