sigmanssery/INAUSIS/DATA/ttcgs_ADS_A.png

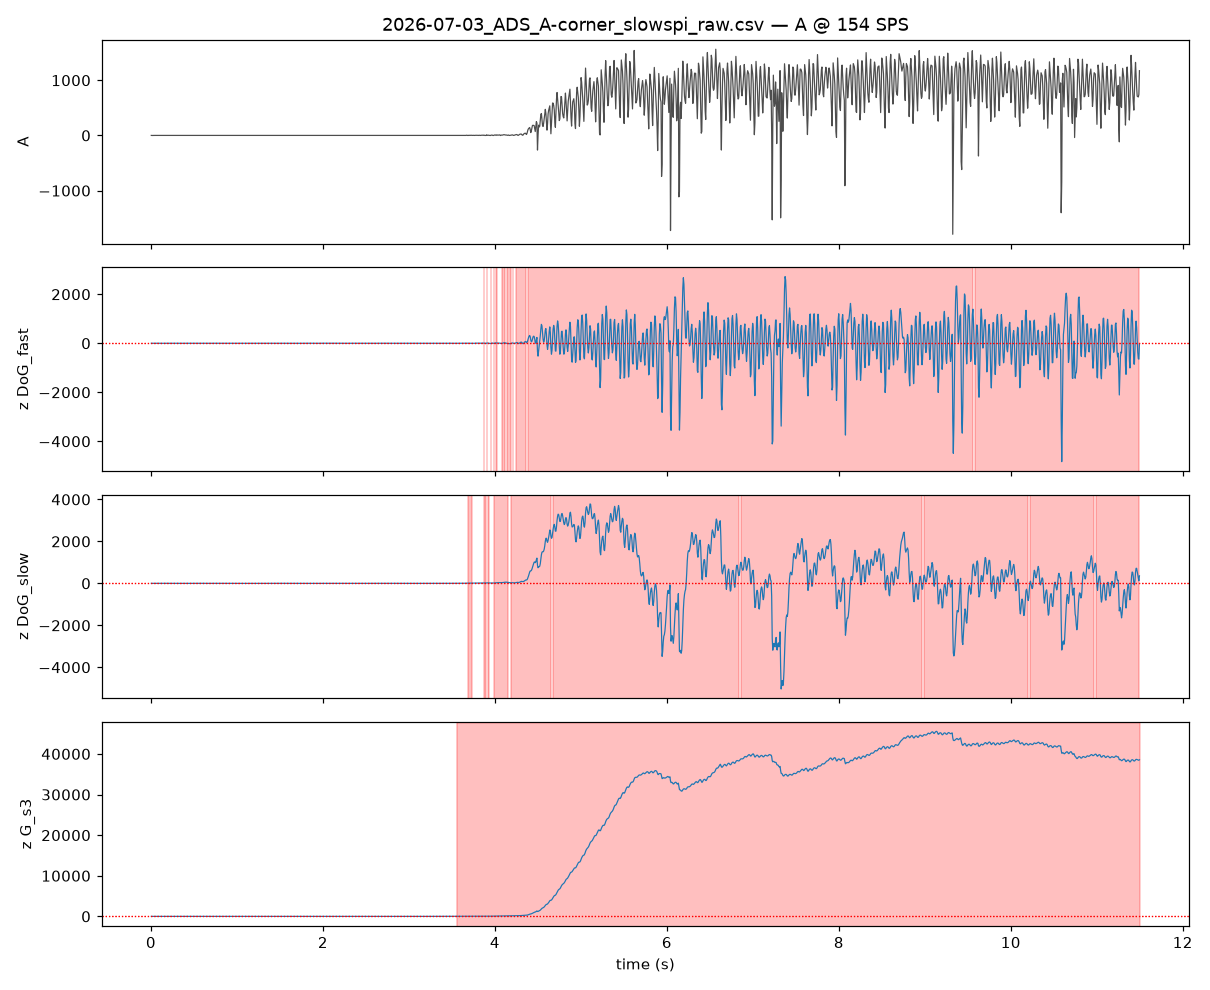
DATA/ttcgs_ADS_A.png
