sigmanssery/INAUSIS/DATA/ttcgs_fsr_dog_vs_ma_fig5.png

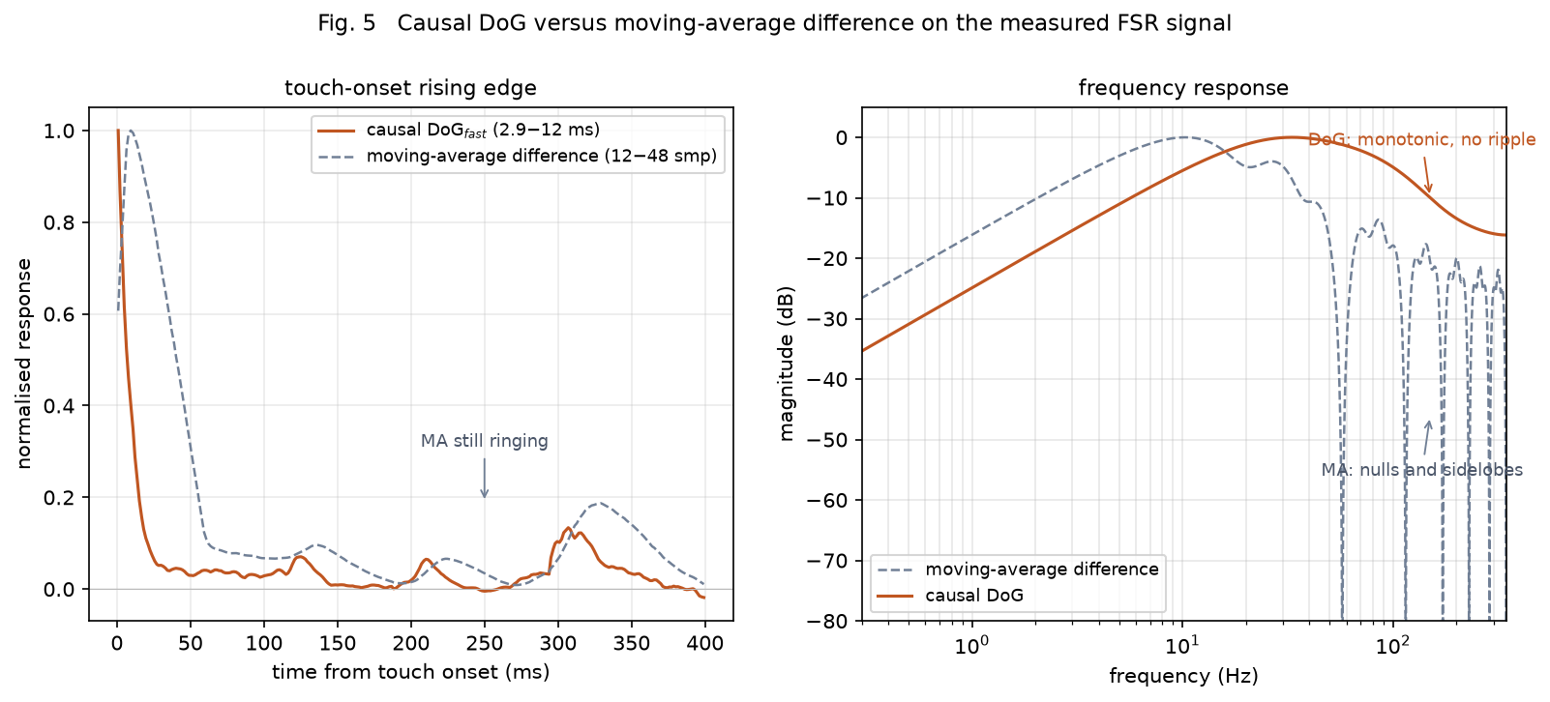
DATA/ttcgs_fsr_dog_vs_ma_fig5.png
