sigmanssery/INAUSIS/DATA/ttcgs_fsr_modalities_fig6.png

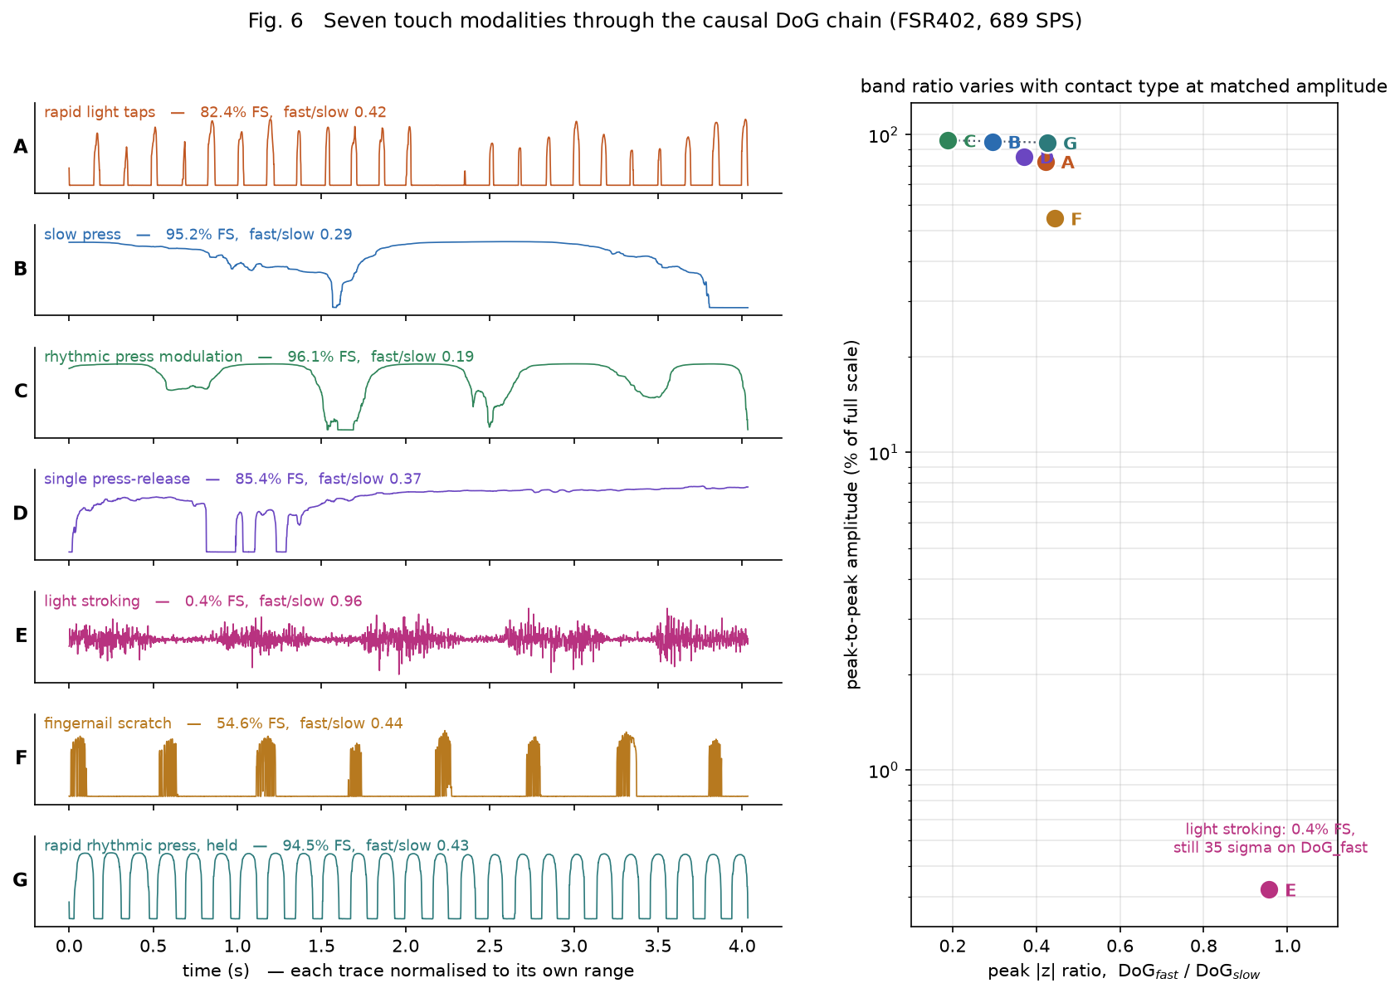
DATA/ttcgs_fsr_modalities_fig6.png
