sigmanssery/INAUSIS/DATA/ttcgs_fsr_touch_fig4.png

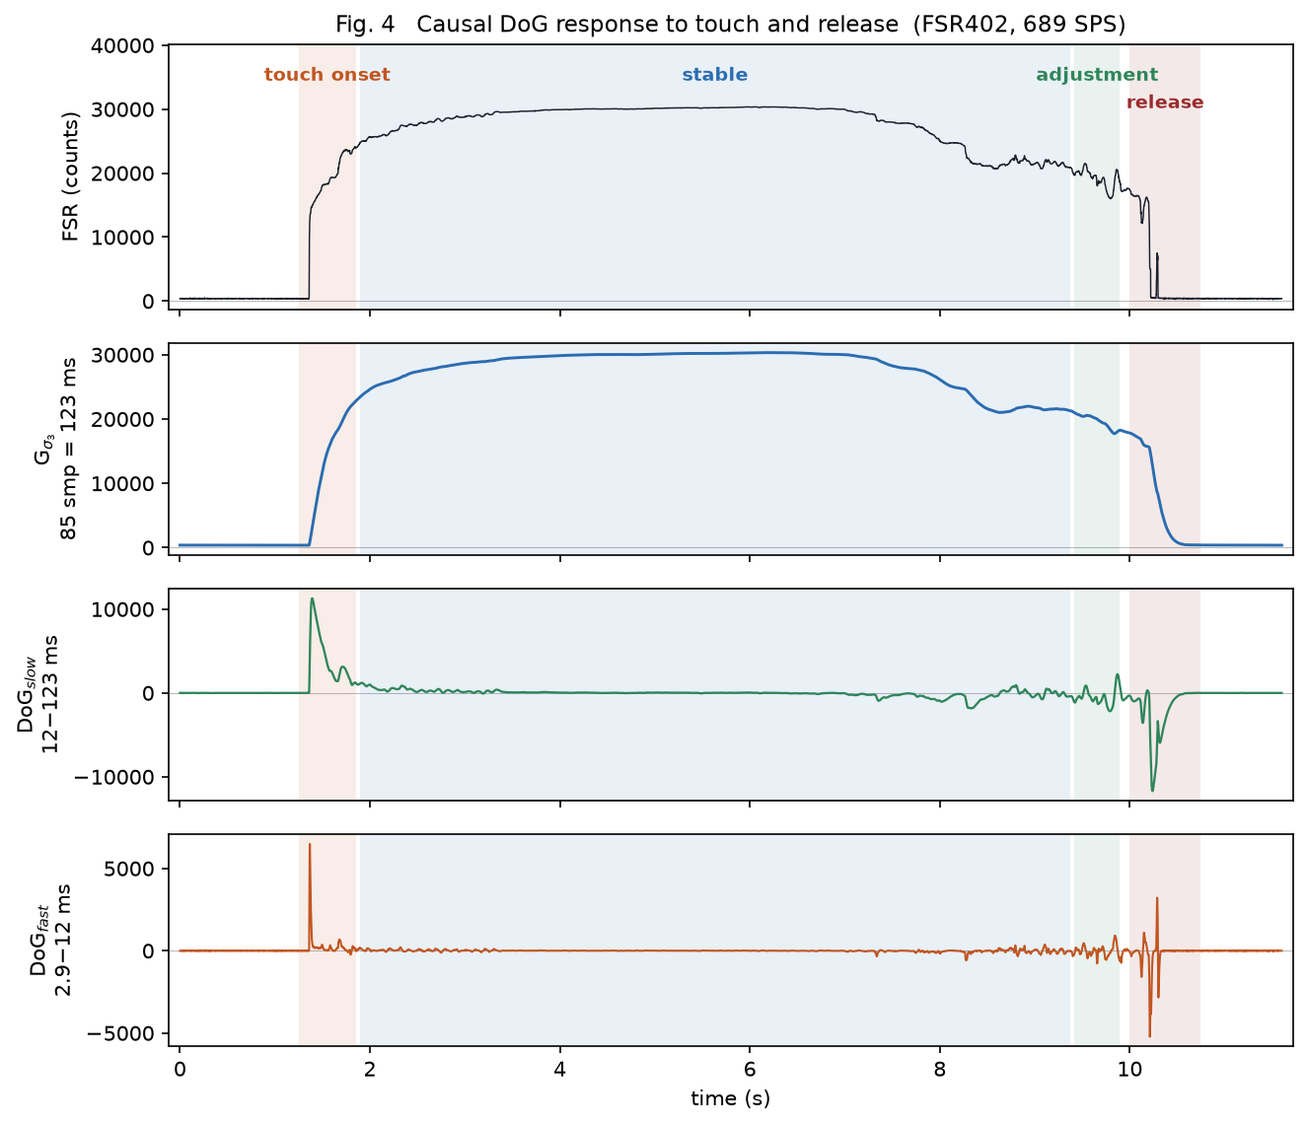
DATA/ttcgs_fsr_touch_fig4.png
