sigmanssery/INAUSIS/DATA/ttcgs_MRE_rp.png

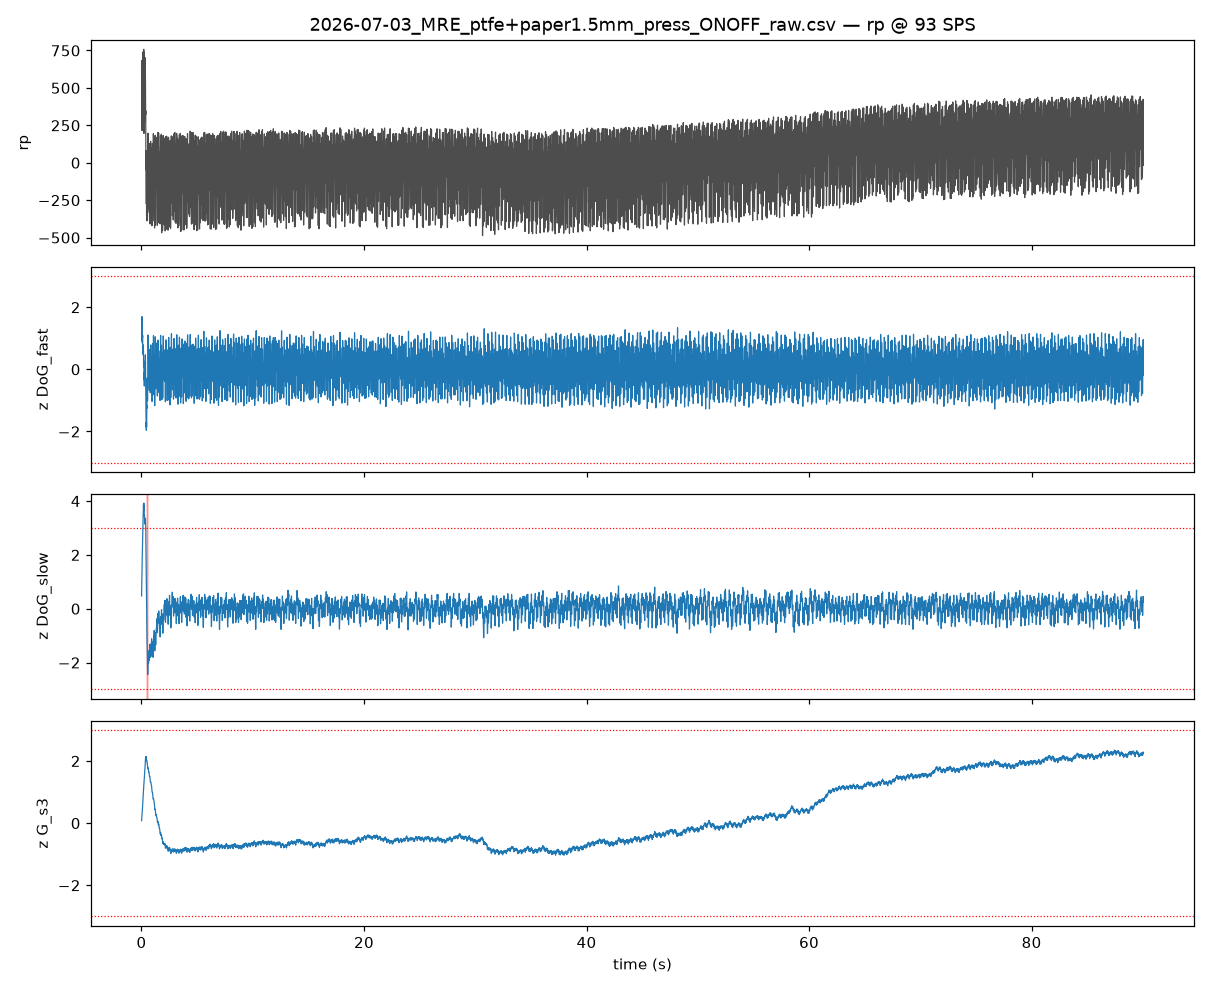
DATA/ttcgs_MRE_rp.png
