sigmanssery/INAUSIS/DATA/ttcgs_poke_L.png

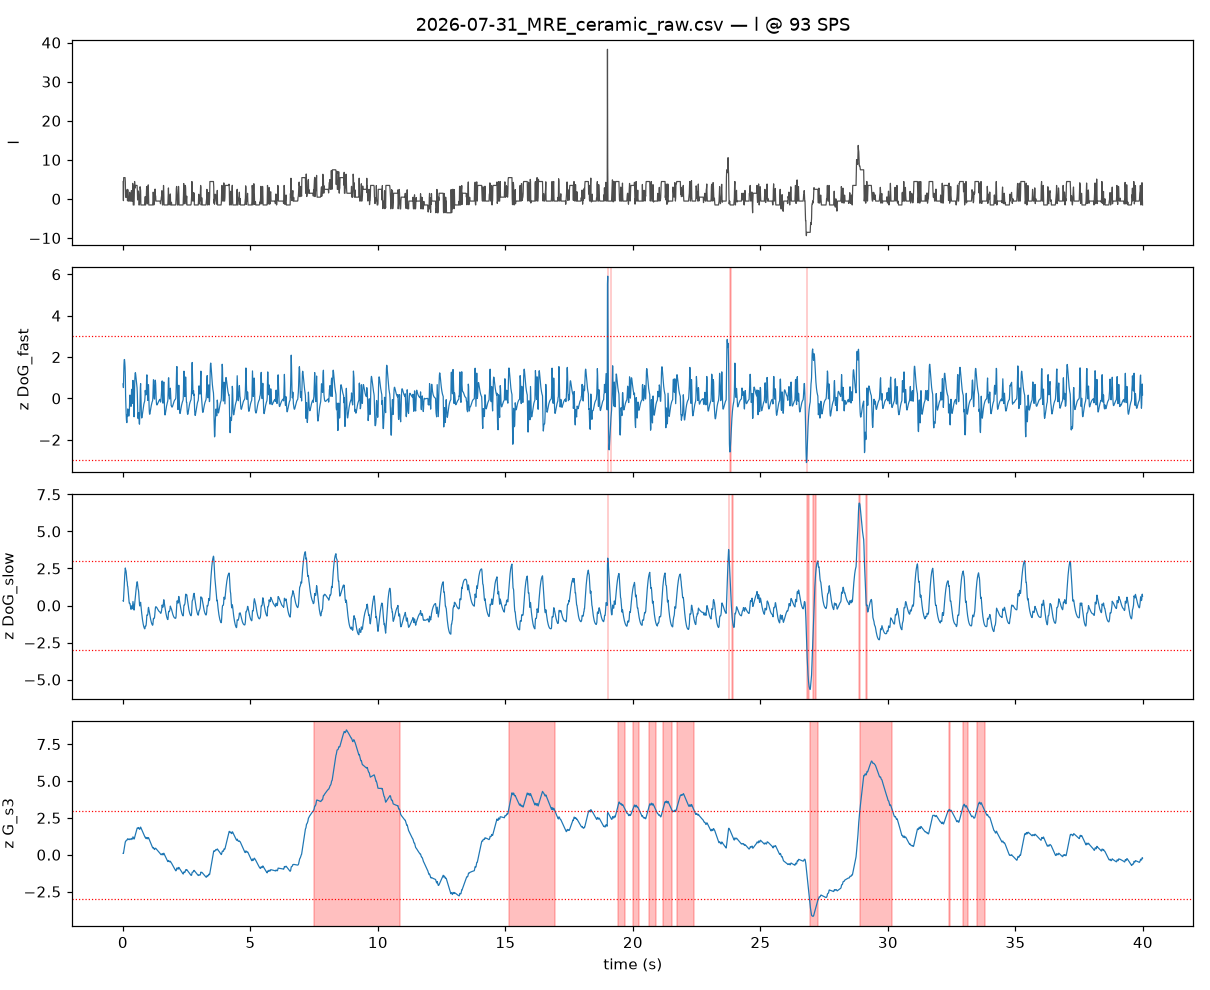
DATA/ttcgs_poke_L.png
