sigmanssery/INAUSIS/DATA/ttcgs_tap_C.png

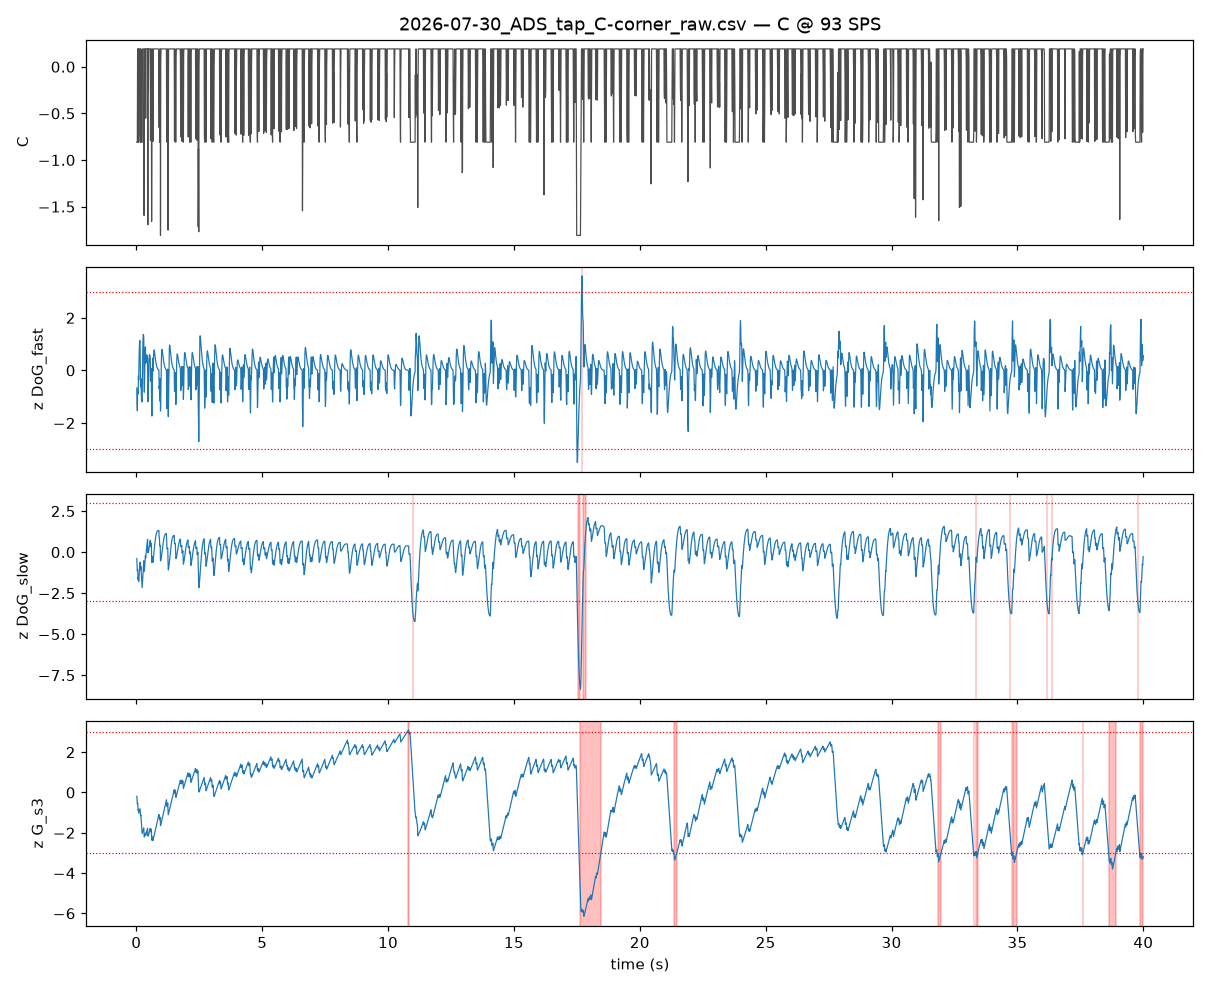
DATA/ttcgs_tap_C.png
