sigmanssery/INAUSIS/PCB/V1/BOM_X004_2026-04-01.csv

ID | Name | Designator | Footprint | Quantity | Manufacturer Part | Manufacturer | Supplier | Supplier Part | Price
1 | CAP-SMD_L3.5-W2.8-FD | C24 | CAP-SMD_L3.5-W2.8-FD | 1 | CA45-B-10V-100uF-K | CEC(振华新云) | LCSC | C129567 | 0.23
2 | USB-C-SMD_KH-TYPE-C-W.SMT-6P | U3 | USB-C-SMD_KH-TYPE-C-W.SMT-6P | 1
3 | R0402 | R1,R2,R4,R5 | R0402 | 4 | RT0402BRD07100KL | YAGEO(国巨) | LCSC | C852472 | 0.018
4 | R0603 | R6,R7 | R0603 | 2 | FRH0603B5101TS | FOJAN(富捷) | LCSC | C49196686 | 0.006
5 | 100nF | C1,C2,C4,C5,C14 | C1206 | 5 | CGA5L1C0G2A104JT0Y0E | TDK | LCSC | C531430 | 0.424
6 | 10uF | C8,C16 | C1206 | 2 | CL31B106KBHNNNE | SAMSUNG(三星) | LCSC | C89632 | 0.067
7 | 10uF | C3,C12 | C0603 | 2 | CL10A106KP8NNNC | SAMSUNG(三星) | LCSC | C19702 | 0.008
8 | 15nF | C6 | C0603 | 1 | C1608C0G1V153JT000N | TDK | LCSC | C5118056 | 0.106
9 | 10nF | C11 | C0603 | 1 | CC0603KRX7R9BB103 | YAGEO(国巨) | LCSC | C100042 | 0.003
10 | 1uF | C15 | C0805 | 1 | CL21B105KBFNNNE | SAMSUNG(三星) | LCSC | C28323 | 0.013
11 | 600Ω | FB | L0603 | 1 | BLM18KG601SN1D | muRata(村田) | LCSC | C85833 | 0.016
12 | ADS114S08BIRHBR | U1 | VQFN-32_L5.0-W5.0-P0.50-TL-EP2.1 | 1 | ADS114S08BIRHBR | TI(德州仪器) | LCSC | C2670116 | 6.88
13 | LDC1101DRCR | U2 | VSON-10_L3.0-W3.0-P0.50-TL-EP | 1 | LDC1101DRCR | TI(德州仪器) | LCSC | C2667045 | 1.605
14 | SOIC-8_L4.9-W3.9-P1.27-LS6.0-BL | U6 | SOIC-8_L4.9-W3.9-P1.27-LS6.0-BL | 1 | LT1763CS8-3.3#TRPBF | ADI(亚德诺) | LCSC | C31066 | 4.042
15 | L0603 | L1 | L0603 | 1 | LQM18PN4R7MFRL | muRata(村田) | LCSC | C114862 | 0.073
16 | C0402 | C7 | C0402 | 1 | CGA0402C0G103J250GT | HRE(芯声) | LCSC | C36911359 | 0.061
17 | C0402 | C13 | C0402 | 1 | GRM1555C1H221JA01D | muRata(村田) | LCSC | C71693 | 0.004
