sigmanssery/INAUSIS/(commit log)

2026-08-05 Add MRE/V1 documentation: material overview and fabrication process
    MRE/V1/README.md — the sensing material: formulation, the three
    substitutions from Liao et al. and why each is a consequence rather than a
    preference, the two readouts and their crossover at dR/dP -> 0, the Wiener
    series bound argument that unifies them, and the two mechanisms that are
    negligible by construction. Ends with the open gate: R(P), L(P) and cyclic
    drift are all pending, and the sensitivity budget's principal open risk is
    stated rather than hidden.
    MRE/V1/PROCESS.md — the recipe and process, written so the skin can be
    reproduced. Leads with a safety section: carbonyl nickel at 1-3 um is
    respirable and nickel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
2026-08-05 Publish the pieces the papers' claims actually rest on
    The repository documented results it could not support. This adds the code and
    artefacts behind each published number.
    01_golden_model/ — the bit-exact fixed-point reference the RTL is verified
    against, plus gen_coeffs.py (dog_coeffs.mem was previously an unexplained
    768-line ROM) and fixed_point_analysis.py, which is where the 53.3/62.8 dB SNR
    figures come from. Without this the central verification claim was uncheckable.
    02_rtl_production/ — ttcgs_board.v, the top that actually runs on silicon and
    which every hardware bring-up claim depends on; top_dual.v and the current
    ads114s08_spi.v / ldc1101_spi.v. The legacy cores in 06_bri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
    [device.cfg]
2026-08-05 Add the idle-baseline figure, and correct what it shows
    The two Rp charts previously in DATA/ were unreadable for a specific reason:
    their y-axes ran to 65535 and down to 255, because the plot auto-scaled to the
    0xFFFF and 0x00FF bad reads. The real signal varies by ~1000 counts, so it
    occupied about 2% of the axis and rendered as a flat line. This figure screens
    the artefacts first, using the procedure documented above, and plots what is
    left.
    Screening the one-hour reference capture removes nothing at all — 329,128 of
    329,128 samples are retained — so the figure is the whole run.
    It also shows something the summary statistics hid, and that DATA/README.md
    previously stated wrongly. Rp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
2026-08-06 Add the figure script, and a stream-rate switch the figures need
    make_paper_figs.py produces the measured touch/release and DoG-vs-MA figures
    directly from a capture. It imports the kernels from ttcgs_golden_model rather
    than re-deriving them, so what it plots is what the coefficient ROM contains,
    and it reproduces two numbers the paper quotes -- 12.0 dB of additional
    attenuation at 300 Hz, and the MA staying within 2.5 dB of peak across
    200-500 Hz -- which makes it a check on those claims rather than a picture of
    them.
    Getting that agreement required fixing the comparison first. The MA baseline
    has to be y[n] = x[n] - MA16(x), matching 05_figures/make_fig6.py. A difference
    of two adjacent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
    [top_dual.v]
2026-08-06 Correct claims the repository could not support
    An external review checked the repository against its own contents and found
    four things wrong. All four are confirmed.
    PnR reports do not match the headline numbers. README.md and CODE/V1/README.md
    quoted 3334 logic cells / 2107 registers / Fmax 45.6 MHz and asserted the
    committed reports were the source. They are not: impl/pnr/ holds a top_dual
    bring-up run from 2026-08-01 against dual_bringup.cst (Logic 1000/8640,
    Register 633/6693), and 3334 / 2107 / 45.6 appear nowhere under impl/. Gowin
    writes every target into one impl/ directory, so the ttcgs_board run was
    destroyed by later bring-up builds. The figures are not withdrawn, but they are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
    [ldc1101_spi.v]
2026-08-06 TIME_MUX is not an option: the ADS driver stalls without it
    Measured 2026-08-06 with identical wiring, changing only this parameter:
    TIME_MUX = 0 ch0 converts once, then stops; ch1..ch3 never update
    TIME_MUX = 1 all four channels update continuously, ~31-48 SPS each
    TIME_MUX was documented as a workaround for two converters contending for one
    supply rail, to be turned off in single-modality use. It is instead the only
    thing keeping the ADS driver running: something stalls the FSM and the 300 ms
    reset clears it. S_WAITDR waits on a DRDY falling edge, and in single-shot mode
    DRDY has to return high before it can fall again, which makes that the leading
    suspect -- but confirming it ne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
2026-08-08 Stop tracking rebuildable Gowin bitstream artifacts
    .fs and .bin were already ignored, but project.binx (434 KB) and
    impl/pnr/project.db (102 KB) were not — so every place-and-route run
    committed half a megabyte of regenerable binary. The gwsynthesis .db was
    ignored while the pnr one beside it was not, which was the oversight.
    The reports under impl/ stay committed deliberately; these two are tool
    state, reproducible by re-running board_pnr.tcl.
2026-08-08 Regenerate the place-and-route evidence the repository was missing
    The headline resource and timing figures were reported from a ttcgs_board
    run whose output a later bring-up build had overwritten — Gowin writes every
    target into one impl/ directory. impl/ was holding a dual_bringup.cst run
    (Logic 930/8640), a different design entirely, and the README said so.
    Re-ran board_pnr.tcl against inausis.cst + board.sdc, no errors or warnings:
    3400 logic cells 2124 registers 5 BSRAM 4 DSP
    Fmax 43.920 MHz TNS setup/hold 0.000, 0 endpoints
    36.521 mW 26.677 quiescent + 9.844 dynamic
    The previous figures (3334 / 2107 / 45.6 MHz) were substantially right:
    BSRAM, DSP, vi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
2026-08-08 Measure the ADS on the wire, and withdraw two conclusions it disproves
    Supersedes 3297b06 "TIME_MUX is not an option: the ADS driver stalls
    without it". That commit was wrong, and so was the sample rate beside it.
    Both claims were inferred from repeated values in the UART stream; neither
    was ever observed on the bus.
    Put a logic analyser on the ADS SPI lines, mirrored onto spare FPGA pins so
    the probes did not contest header holes with the sensor harness. 2.5 s at
    4 MHz, on a TIME_MUX = 0 bitstream:
    DRDY falling edges 1591 over 2.500 s
    interval 1572.2 us sd 0.4 us (min 1571.2, max 1573.2)
    stalls 0
    => 636.04 Hz aggregate, 159.01 SPS per channe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
2026-08-08 Correct the SPI clock frequency in comments: 482 kHz, not 241 kHz
    The divider comments were wrong by 2x in both directions. The counter wraps
    at CLK_DIV and the falling strobe fires at CLK_DIV/2, so the SCLK period is
    CLK_DIV system clocks -- not 2*CLK_DIV. CLK_DIV=56 is 482 kHz and CLK_DIV=14
    was 1.93 MHz, where the comments claimed 241 kHz and 964 kHz.
    A logic analyser measured 2.074 us per clock, confirming 482 kHz.
    Comments only; CLK_DIV values are untouched and the bitstream is unchanged.
    The decision the comment describes -- slow the link down, it was marginal on
    the jumper harness -- is unaffected. Only the number was wrong. Applied to
    every copy of this file in the tree so a stale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
    [ads114s08_spi.v]
2026-08-08 Actually ignore the Gowin .db this time
    The previous commit added *.binx, which works, and impl/*/*.db, which does
    not: a slash in the middle of a pattern anchors it to the .gitignore file's
    own directory, so that rule looked for <root>/impl/ and matched nothing.
    The impl/gwsynthesis/*.db line it replaced had the same flaw and had never
    matched anything either -- the file simply happened not to be added.
    project.db was then re-staged by the place-and-route commit and went in at
    105 KB. Anchoring the patterns with **/ and untracking it for real.
    Verified with git check-ignore rather than assumed this time.
2026-08-08 V3: let the two boards have different goals
    The sensor board and the compute board were being held to the same
    constraint, and only one of them earns it. The coil has to couple to the
    elastomer at contact scale, and SNOA930 wants ground pour 30% of the coil
    diameter away, so a 7.62 mm coil forces a 12.2 mm keep-out and the sensor
    board is small because physics says so.
    The compute board is small because it inherited a shield outline. It holds
    two converters and a regulator, it plugs into the FPGA, and it sits on the
    bench -- the FPC is what reaches the gripper. So it stops being small and
    becomes an evaluation board.
    The case for it is the defect list. Nearly everything that has cost this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
2026-08-08 V3: keep the FPGA pins reachable, and socket the op-amp
    Two consequences of enlarging the compute board that the first draft missed.
    A board stacked on the Tang Nano covers its headers, and about thirty I/O are
    currently unused. Rather than fan out everything, split by whether a pin is
    carrying a signal: idle pins go to a labelled expansion header where an open
    stub costs nothing, and pins in use stay on J_DIG, which is already a
    deliberate ground-flanked measurement branch. CLKIN and anything routed near
    the tank must not be stubbed at all -- a fan-out is an antenna and a
    reflection point on exactly the signal being kept quiet -- so branches on live
    signals are taken after the series resis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
2026-08-09 V3: the single ground pin, and three pieces of advice not to follow
    The header exposes one ground, so every return current between the boards
    goes through a 2.54 mm pin -- roughly 20 mohm and 10 nH. A large plane on the
    compute board does not help, because the bottleneck is the pin.
    Quantified, because the conclusion is not the obvious one. The DC offset does
    not corrupt the analog measurement: 30 mA of supply return develops 600 uV,
    which is 8 LSB, but the ADS references AINCOM sensed at the sensor board's
    star point, so a difference between the two boards' grounds is common-mode.
    That is what the AINCOM sense line was for.
    The AC side is where it matters, at V = L*di/dt: 10 mV of bounce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
2026-08-09 Add a roadmap of work deliberately deferred
    Ideas kept surfacing across sessions and then getting lost, or quietly
    becoming the current revision's scope. Both failure modes have cost this
    project real time -- the design notes are scattered across three places and
    the place-and-route evidence went missing twice.
    Each entry says what it is, why it is not being done yet, and what would have
    to become true for it to be worth doing. An entry with no trigger condition
    does not belong on the page.
    Nine entries: the MCU that would close the Manchester loop and take the
    bidirectional datapath from R to V; a custom two-layer flex with a ground
    plane under the high-impedance AIN group; moving the buf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
2026-08-09 V3: the Manchester connector, and a bead rather than a Pi filter
    Adds J_LINK, four positions carrying line / 3V3 / GND / reset. Not new scope:
    line is pin 42 on the left header, which the compute board covers, and section
    1 already requires covered signals to be re-exposed. It earns its own labelled
    connector rather than a slot on the expansion header because it is the
    interface to the downstream consumer -- four jumper wires to any MCU dev board,
    with no footprint committed. That is what makes the closed-loop demonstration
    possible, and closing the loop is what moves the bidirectional datapath from R
    to V.
    Specifies the incoming supply filter: one 0805 bead, 600 ohm at 100 MHz, rated
    above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
2026-08-13 V3: record what the layout actually did, and price the stacking idea
    Three things came out of laying the board out that are better than the
    specification asked for, plus one idea that turned out cheaper than it looked.
    The series-resistor rule generalises. The spec named eleven lines that needed a
    470 ohm position; the board gives every fanned-out FPGA pin a bare 0805 pad pair
    instead -- net NN on one side, NNA on the other -- so each can take a resistor,
    a 0 ohm link, or a solder bridge. Twenty-four pairs, including all eight 1.8 V
    bank pins. The lesson behind it was specific: during the logic-analyser session
    a series resistor was wanted on a line with no pad for one, and that board had
    z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
2026-08-16 Fix the one-bit ADS read shift, and correct the count-to-resistance calibration
    RD_DELAY (~1 us between the DRDY edge and the first SPI clock) moves the
    sampling instant off the bit boundary that was losing a bit on 1.7-27.5% of
    reads. Verified with a 1 Mohm soldered from the excitation pad to AIN5:
    27.5% corrupted -> 0.036% (1 sample in 2741).
    The corrupted samples were the HALVED ones, not doubled. The earlier
    calibration in DATA/README.md was fitted to that corrupted population and was
    wrong by 2x throughout; it is replaced by the ratiometric form
    R = 100 kohm * (32767/counts - 1)
    which reads 991.5 kohm for the 1 Mohm part (0.85% error, sd 0.040%). The
    tell that was missed at the t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
    [ads114s08_spi.v]
2026-08-16 Add the FSR402 force calibration protocol
    The chain is calibrated in ohms but every pressure measurement so far has counts
    on one axis and nothing on the other. The FSR402 has a specified active area and
    range, so it supplies a force axis without waiting on the elastomer.
    One stepped load-unload sweep plus a tap series produces the force axis, the DoG
    waveforms for the TTCGS figures, and the evidence for the sample-rate decision,
    which until now has been argued from a model rather than measured.
    Two things the protocol is built around:
    - A screw clamp is displacement control, so force decays across the dwell as the
    FSR creeps. The scale must be read at the end of the dwell, in the same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
2026-08-16 Correct the FSR protocol from the first run's results
    The first sweep produced four usable points out of eighteen. Three separate
    causes, all now written into the protocol:
    - The load steps were in the wrong place. 400-2329 g put fourteen points in the
    region where the FSR is bottomed out at 1-2 kohm; the part's curve is steep
    below 500 g and flat above 1 kg. Steps now run 0-1000 g with most of them
    under 400 g.
    - The divider is sized for the elastomer, not for this sensor. At 3 kohm a
    100 kohm divider gives 309 counts/kohm against 1939 for a 10 kohm one, and a
    43 kohm series resistor in the FSR leg meant the divider was mostly measuring
    the fixed resistor. Fitting 11 kohm from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
2026-08-16 Make check_stream report the bit-shift fraction directly
    Range and distinct-value count cannot show a one-bit shift, and both were read
    as if they could - a stable fixed resistor legitimately has only a few distinct
    values, and the shifted population sits inside the same range. Three separate
    diagnoses this session were made from those two statistics and had to be redone
    from the distribution.
    The tool now prints the six most common values and, against the modal value,
    how many samples land at half or double it. Verified against the three cases
    actually seen: 45.7% halved on the current 100 kohm reading, 0.0% on the
    working 1 Mohm run, and no false positive on a continuously varying FSR tra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
    [check_stream.py]
2026-08-16 Fix the random one-bit read shift: reset the SPI divider phase on CS
    The clock divider free-ran, so CS fell at an arbitrary point in its 56-clock
    period and whichever strobe came next decided how many MISO samples the
    transaction contained:
    clk_cnt 0..27 at CS -> fall first -> F R F R ... F16 R16 F17(end) -> 16 rises
    clk_cnt 28..55 at CS -> rise first -> R F R F ... R17 F17(end) -> 17 rises
    bit_cnt counts falls, so the transaction always ends on the 17th fall, but the
    number of RISING edges inside it - the number of MISO samples - differed by one
    purely by arrival phase. Sixteen samples put the data one bit low in
    spi_rx[15:0], which is the exact factor-of-two population present i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
    [ads114s08_spi.v]
2026-08-16 Gate CS on the divider phase instead of restarting the divider
    The previous commit removed the shift - three consecutive runs reported zero
    shifted samples against a fixed 100 kohm - but added roughly +/-170 counts of
    noise to every channel, including ch0 on that fixed resistor and the three
    inputs that had been sitting quietly at 0-2 through their dividers.
    Restarting a running divider is a phase discontinuity on a clock that reaches
    the ADS, and the ADS is mid-conversion when it happens.
    The ordering itself was never the noisy part, and the pre-fix data shows it:
    56% of transactions already asserted CS at clk_cnt 28..55, which is the
    rise-first case, and those returned both the correct 3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
    [ads114s08_spi.v]
2026-08-16 Drive MOSI at CS assertion; the ADS was never being configured
    A 24 MHz logic-analyser capture of MOSI settles what several rounds of guessing
    did not. Decoding DIN at the edges the ADS samples on:
    what the ADS received 21 00 26 / 21 00 0E / 21 00 06
    what was intended 42 00 5C / 42 00 4C / 42 00 1C
    Every byte arrived one bit late. 0x42 is WREG and 0x21 is RREG, so the four
    INPMUX writes were read-register commands; the single-byte 0x08 START arrived as
    0x04 POWERDOWN. The converter was never configured and never told to convert,
    which is why the reads were noise rather than a shifted value.
    Cause: ads_din was driven only on sclk_fall. Once the launch gate forced
    rise-first ord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
    [ads114s08_spi.v, check_stream.py]
2026-08-16 Revert the ADS engine to cef5df2; three attempted fixes all made it worse
    Restores the driver to its last state that produces sensible readings. Four
    variants were tried on hardware today and the original is the only one that
    converts:
    original (free-running divider) ch0 3204/1602 split, ch1-3 quiet at 0-2
    divider phase reset on CS no shift, but every channel +-170 noise
    CS gated on divider phase same: perfect framing, railing data
    MOSI driven at CS assertion all channels read exactly 0
    LAUNCH_PHASE = 0 (fall-first) all channels read exactly 0
    The MOSI change was based on a misreading. The wire does carry a leading stale
    bit before each command, but th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
    [ads114s08_spi.v]
2026-08-16 Add fix_shift.py to recover the random one-bit halving in host post-processing
    The RTL fault stands: the free-running divider makes about 44% of reads take 16
    MISO samples instead of 17, halving them. A 24 MHz logic-analyser capture showed
    the data on the wire is correct, so the loss happens in the FPGA's capture and
    the two populations are exactly 2:1 and well separated.
    Halving only ever decreases a value, so the correct population is the upper one.
    A rolling 70th percentile lands inside it (56% of samples are correct), and any
    sample below 0.72 of that reference is doubled.
    Validated against a 4290-row synthetic sweep with 44.5% halving and known truth:
    per-step medians 13/13 corre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
    [fix_shift.py]
2026-08-16 Add a deterministic --halved mode and a warning when the shift is undetectable
    dual_orig.fs on the current wiring halves 100% of reads, not 44%: 1660 samples
    across three runs show only 1604/1605 against a known 100 kohm whose true
    reading is 3208. A uniform halving is the better state - it costs one LSB and
    nothing else - but the rolling-percentile method cannot see it, because there is
    no upper population to reference. It would silently return double the resistance.
    --halved multiplies everything by 2 and refuses if any sample exceeds 16383,
    which would mean the batch is not uniformly halved after all.
    Without the flag, a correction rate well under the 44% expected of a mixed state
    now p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
    [fix_shift.py]
2026-08-17 Reference the shift detector to the upper cluster, not the mode
    The mechanism is a dropped sample, so a corrupted value is always the smaller
    one. Taking the modal value as the reference made the label flip between
    'halved' and 'doubled' depending on which cluster happened to be modal, so the
    same fault read as two different ones across consecutive runs: 38.0% halved,
    then 58.8% doubled, then 58.8% doubled.
    Anchoring on the larger cluster gives 38.0 / 41.2 / 41.2% halved for those same
    three runs.
    Also records that the phase is not reproducible across power cycles: the same
    bitstream halved 100% of reads before a reflash and about 40% after, so
    fix_shift.py's --halved mode cannot be assume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
    [check_stream.py]
2026-08-17 Read each conversion five times and keep the largest magnitude
    The read path halves 38-52% of samples and the proportion is not reproducible
    across power cycles - one session ran at 100%. Four attempts on 2026-08-16 to
    fix the underlying divider phase race each made it worse or stopped conversion
    entirely, so this takes the other route: be immune to it rather than solve it.
    Corruption only ever halves, so the largest of N reads is correct unless all N
    were corrupted. In single-shot the data register holds until the next START, so
    re-reading returns the same conversion.
    1 read ~44% wrong 4 reads 2.6%
    2 reads 19% 5 reads 1.0%
    3 reads 7.7% 6 reads 0.4%
    Cost is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
    [ads114s08_spi.v]
2026-08-17 Add a single-channel mode and use it for corner B
    The four-channel round robin costs a factor of four on whichever input has a
    sensor, because it waits out three conversions of inputs sitting at 0-2 counts,
    and pays a 52 us INPMUX write per channel that a fixed mux does not need.
    SINGLE_CH = 0 1713 us x 4 -> 146 SPS per channel
    SINGLE_CH = 1 1660 us -> 602 SPS on the selected input
    top_dual now instantiates it with SINGLE_CH=1, SINGLE_IDX=0 (AIN5, corner B).
    ch1..ch3 hold their reset value while it is set; put it back to 0 for
    dual-modal or four-corner work.
    This changes the premise of the sample-rate item in ROADMAP.md. That entry
    treats 159 SPS as the hardware's limit an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
    [ads114s08_spi.v, top_dual.v]
2026-08-17 Raise the stream rate to 1 ms, and keep the INPMUX write in single-channel mode
    Single-channel mode did not change the logged row rate: still about 110 rows/s.
    The converter was not the limit. top_dual's emitter fires one set of lines every
    PERIOD, and STREAM_MODE 0 sets that to 10 ms, so the host has been receiving
    100 Hz data in every capture regardless of the conversion rate. The 159 SPS in
    SAMPLE_RATE.md is the ADS's conversion rate; it was never the rate of the data
    anyone analysed.
    STREAM_MODE 1 was already written for exactly this - 1 ms period, slots 0-3, its
    comment says "touch/release figures" - so this just selects it.
    Also reverts the mux-write skip. Dropping the 52 us INPMUX w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
    [ads114s08_spi.v, top_dual.v]
2026-08-18 Add a smoothness DP mode that recovers the halving on fast transients
    The rolling-percentile method needs the signal quasi-static inside its window,
    which rules out exactly the touch and release edges Fig 4-5 is about. Raising
    the stream rate to ~704 Hz makes a different approach work: a 20-50 ms contact
    edge now spans 14-35 samples, so the underlying signal is heavily oversampled
    and smooth even where it is steep.
    Each sample's true value is either x or 2x. --dp picks the assignment
    minimising the total second difference over the whole sequence, via a
    four-state Viterbi. Choosing wrong costs a factor-of-two jump, which is far
    larger than the sample noise, so the criterion separates cleanly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
    [fix_shift.py]
2026-08-18 Close the sample-rate question and archive the touch figures
    The manuscripts assume 1 kSPS and this repo has carried an open discrepancy
    against a measured 159 SPS since 2026-08-07. The converter was never the limit.
    Two things upstream were spending the budget: the four-channel round-robin, which
    made the one channel with a sensor wait out three conversions of inputs sitting
    at 0-2 counts, and STREAM_MODE 0's 10 ms UART burst, which capped every capture
    before 2026-08-17 at 100 Hz regardless of conversion rate.
    Single channel plus the 1 ms stream period gives 689 SPS, where the RTL's
    sigma = 2/8/85 samples land at 2.9/11.6/123 ms against the papers' 2/8/85 ms.
    Within 40% on all three bands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
2026-08-18 Record the divider change: 10.855 kohm from 2026-08-16
    An FSR402 works between about 1 kohm and 100 kohm, where the board's 100 kohm
    divider barely moves - 1 to 30 kohm spanned only 3619 counts against 10650 with
    a 12 kohm fitted in parallel. The touch series therefore converts with 10.855
    kohm, measured from two independent known resistors rather than assumed from
    the nominal 12 par 100.
2026-09-02 Sync the RTL to the shipping design and add the 08-27..09-02 record
    The RTL in this repo had not moved since 2026-08-04 and was a month behind
    the working sources: it lacked the raw converter channel, the on-chip
    discriminator, the cold-start fix, the calibration recovery, the 5-sigma
    threshold and the maintained noise estimator, and twelve files were absent
    altogether. Committing the new DATA documents without it would have left
    documents describing v12 behaviour beside RTL that cannot produce it.
    All 28 Verilog sources and the coefficient ROM are now synchronised.
    Build flags as committed, which are those of the 21-hour capture running
    at the time (board_v12_real.fs, User Code 0x250E):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
    [ads114s08_spi.v, ads_regcheck.v, dog_fir_multi.v, dsp_chain.v, frame_uart_mirror.v, halfduplex_ctrl.v]
2026-09-12 Record that the inductive channel is masked, not merely untested
    The six inductive dimensions (12-17) are overwritten by RAW_DIM, AUX_DIM and
    the debug taps, so the 21-hour soak of 2026-09-02 carries no information about
    that path at all -- and a frame with a dead converter behind it is still a
    well-formed frame, so nothing downstream could tell. Measuring it needs a third
    build configuration (MIRROR=1 with DEBUG_TAPS=0) that is neither the production
    nor the resource-quoting one.
    Also notes that the "L is quantisation-limited" finding in the paper was taken
    in July, before v5 gave the calibration variance four fractional bits, so it may
    already be fixed and nobody has checked.
    Co-Authored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
2026-09-12 Add the AD5254 floor rig, and point impl/ at the build the paper cites
    The detection floor of 2026-08-30 (41 -> 100%, 27 -> 60%, 20 -> 0%) was a limit
    of synth_press, whose smallest increment is one count per sample, not a limit of
    the analogue chain. Two AD5254s in series give a 2040-step rheostat in place of
    the FSR, so a calibrated sub-count step goes through the real converter: at the
    rest point one step is 383.1 ohm, fitted from the recordings rather than assumed
    (the nominal 390.625 is 1.9% out, well inside the part's +/-20%).
    Measured, charger unplugged and the room empty: DoG_slow detects 10/10 at 51.0
    counts, DoG_fast at 168.1, G_sigma3 at 3.90, the raw channel at 74.4, with zero
    f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
2026-09-12 Add the power baseline bitstream, and record that the method did not work
    power_null holds every LED off and clocks one counter, as a second bitstream to
    subtract from the real one: the 38.3 mW FPGA core figure cannot be measured
    directly because the Tang Nano's regulators feed the FPGA, the FT2232, the
    oscillator and the LEDs from one USB rail, but a DIFFERENCE can be. And the
    difference is the interesting half, since 26.4 mW of the 38.3 is static leakage
    present in any bitstream -- what a differential isolates is the 11.9 mW of
    dynamic power, the term the paper says scales with the design.
    It does not work. The tool predicts 14.0 mW at the FPGA, about 16.5 mW at the
    USB once the regulator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
    [power_null.v]
2026-09-12 Correct the front page: withdrawn acronym, and the manuscript split
    The landing page still expanded TTCGS as "Splash" -- withdrawn because it is one
    letter from Gaussian Splatting and reads as a reference to it, which the method
    has nothing to do with. The expansion is Scale-space, in Lindeberg's sense, and
    that is the term the filter manuscript uses throughout. The repository is public,
    so the front page was naming the project differently from the paper it carries.
    It also described "two companion manuscripts". The front-end work did not fit a
    single 8-page submission and was split into four; the material paper remains
    separate and its sensing material is still uncharacterised. The table n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
2026-09-12 Let the floor sweep repeat, and fix the BUILD_ID that never shipped
    The AD5254 sweep was one-shot: N_AMP rungs x N_REP presentations, then park at
    the rest code forever. At N_REP=10 that is 12.75 minutes, so every rung's
    detection floor rested on ten presentations and could not be placed more tightly
    than ten allow. P_END now restarts at rung 0. It costs no new register -- a_i,
    rep, t, acc and ph all already carry reset and in-flight assignments, so this is
    mux inputs on registers that exist. `done` stays latched, because "a full pass
    has completed" is still true and "stopped" no longer is, and rung N_AMP appears
    in aux for exactly one tick per pass, which gives an offline drift check its
    cy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
    [digipot_sweep.v, dsp_chain.v, ttcgs_sys.v]
2026-09-13 Tell which AD5254 bus is alive from the rest level, and count false alarms as events
    rig_bus_check.py answers "which bus is actually being written" in ten seconds,
    without a rebuild and without the LED. A channel that has never acknowledged a
    write sits at the part's EEMEM midscale (128), not its target, and at REST_CODE
    1746 that leaves the chain a known number of steps short: 508 for a dead bus A,
    214 for a dead bus B. With the fitted 383.10 ohm step and the divider law, each
    state has its own rest level, anchored on the 2026-09-12 run where both buses
    were written. Checked against three captures whose state is known independently:
    1572.0 -> both (off 0.0), 1820.0 -> neither (off 7.5), 165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
    [fa_events.py, floor_from_sweep.py, rig_bus_check.py]
